calstar/le2-pcb-hardware/flight-module/Flight_board.DXF

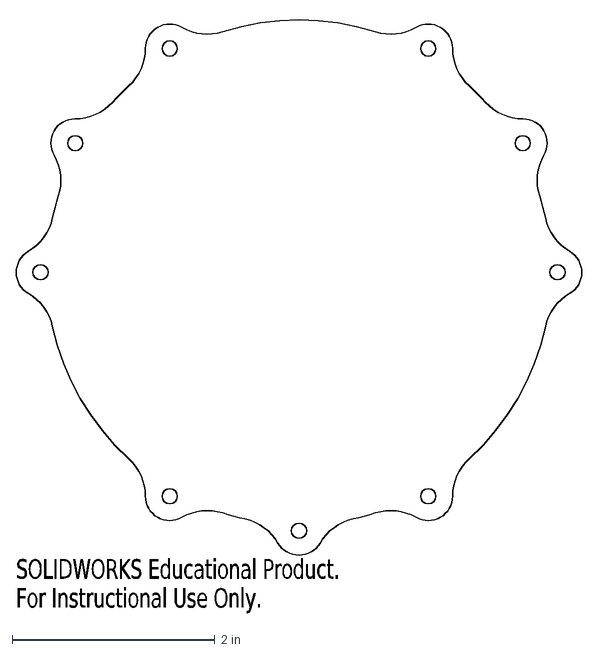
[picture p1: CAD file, 2024-01-30]
flight-module/Flight_board.DXF
SOLIDWORKS Educational Product.
For Instructional Use Only.
