calstar/le2-pcb-hardware/flight-module/Power-board/Power-board.pdf

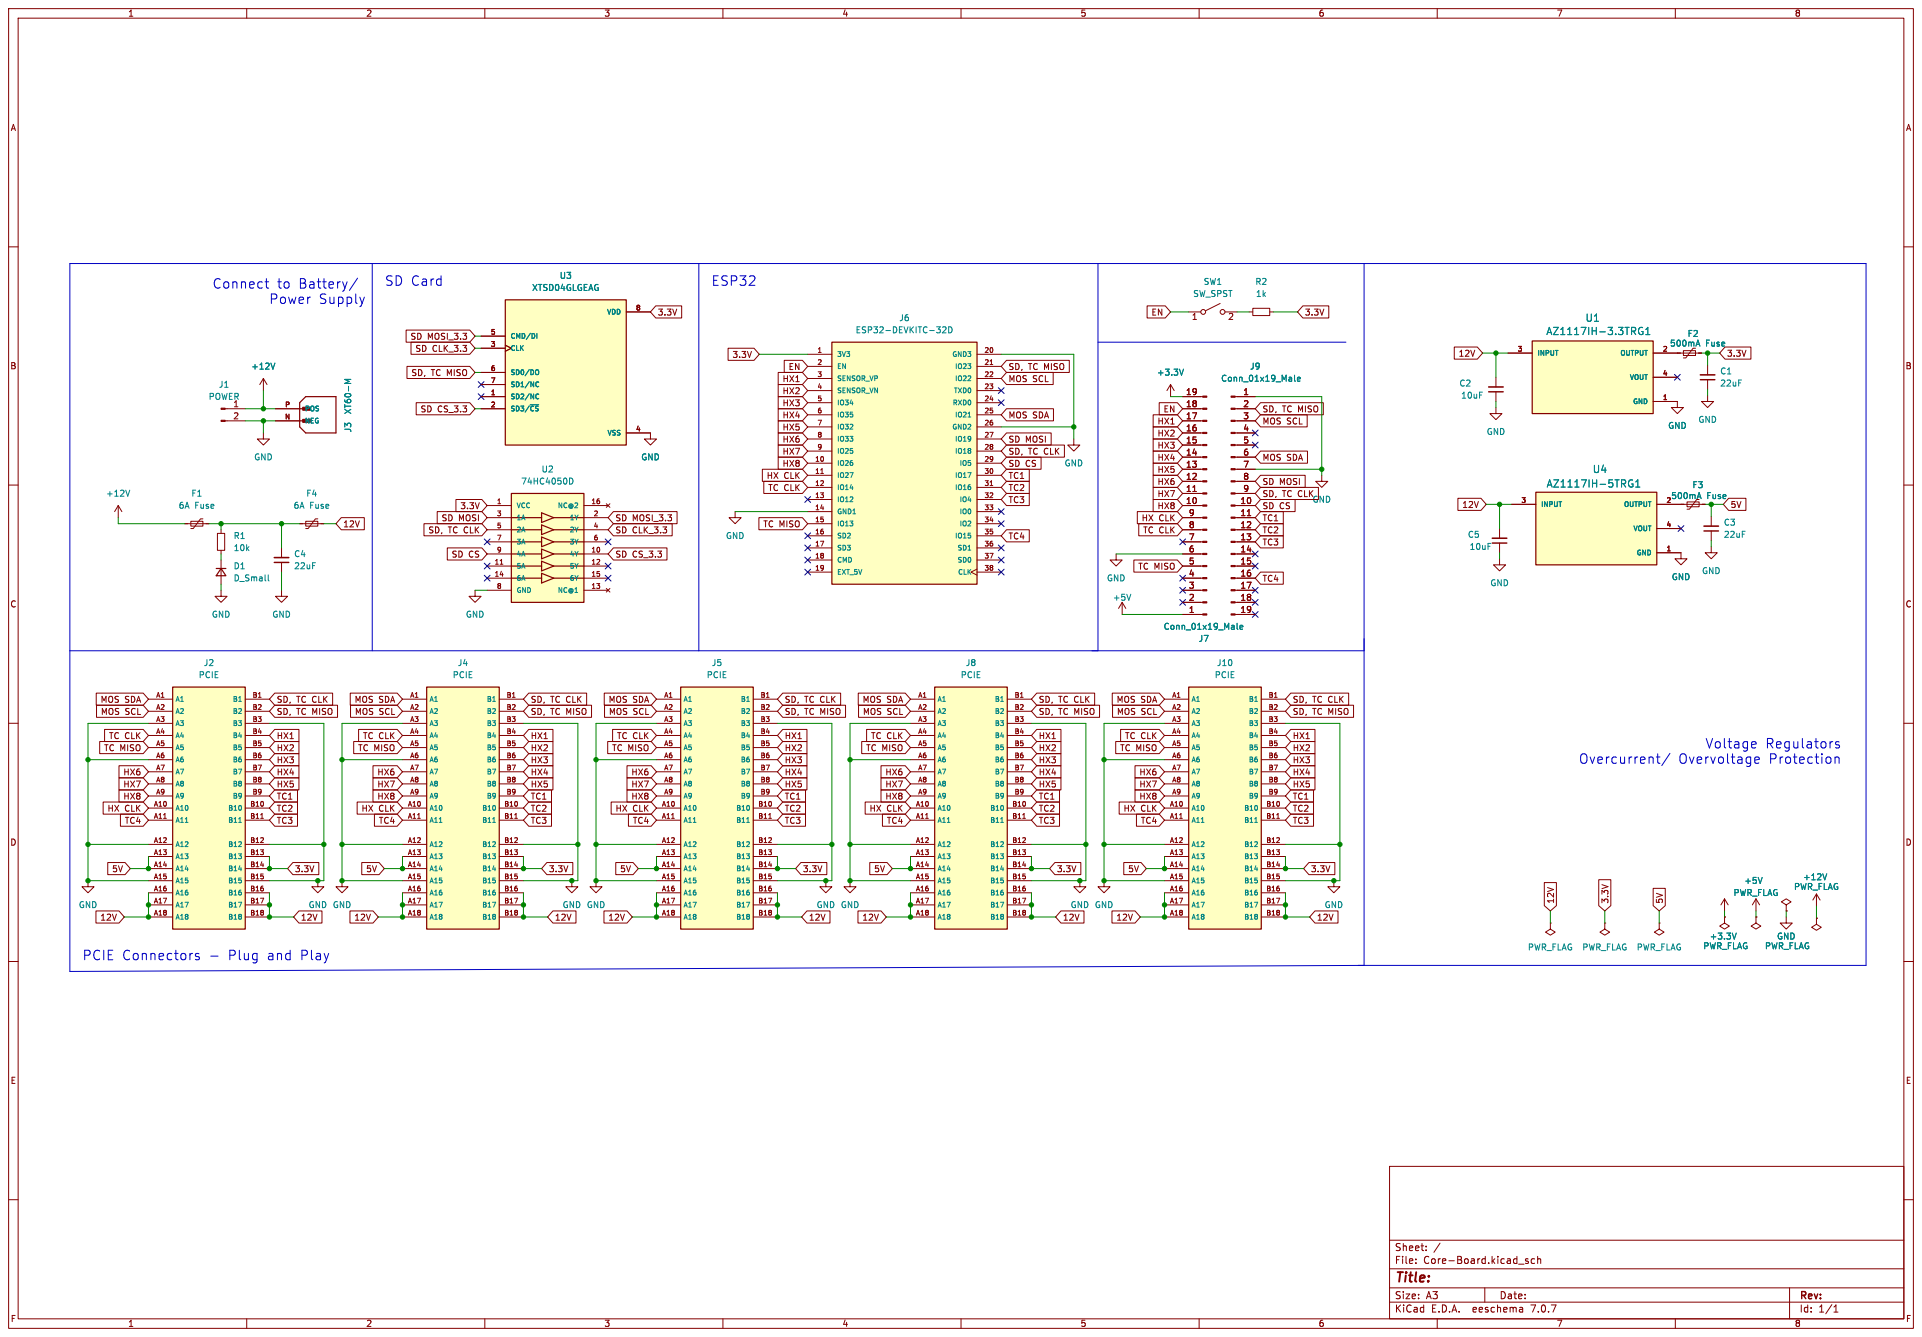
[picture p3: page 1]

EN MOS SCL MOS SDA

TC CLK MOS SCL MOS SDA

Id: 1/1 Title: File: Core-Board.kicad_sch Sheet: /
