calstar/le2-pcb-hardware/ground-module/MOSFET-board/MOSFET-board.pdf

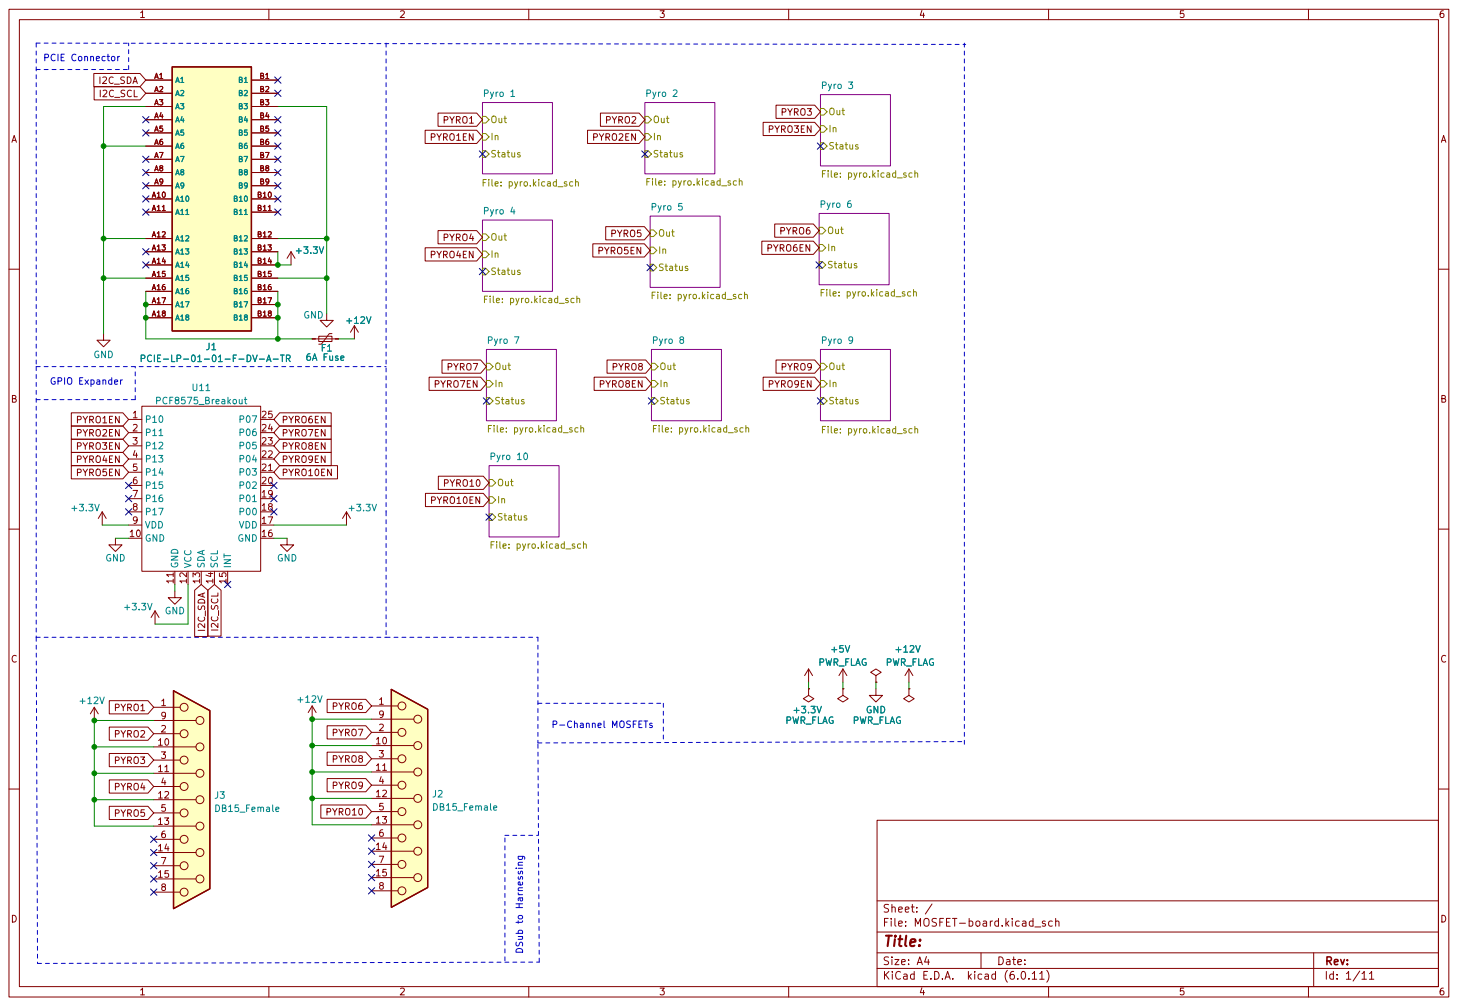
[picture p4: page 1]

In Pyro 7 File: pyro.kicad_sch Status Out
In Pyro 4 File: pyro.kicad_sch Status Out
In Pyro 10 File: pyro.kicad_sch Status Out
PYRO10 PYRO7EN

In Pyro 3 File: pyro.kicad_sch
In Pyro 2 File: pyro.kicad_sch Status Out
In Pyro 9 File: pyro.kicad_sch Status Out

In Pyro 6 File: pyro.kicad_sch Status Out

Id: 1/11 Title: File: MOSFET-board.kicad_sch Sheet: /

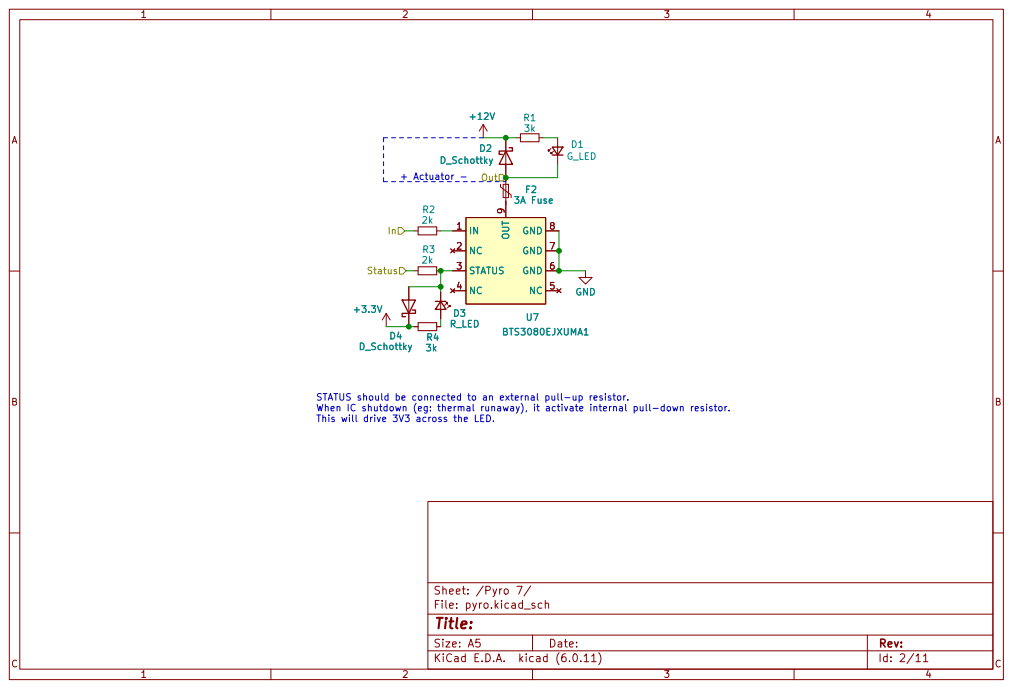
[picture p5: page 2]

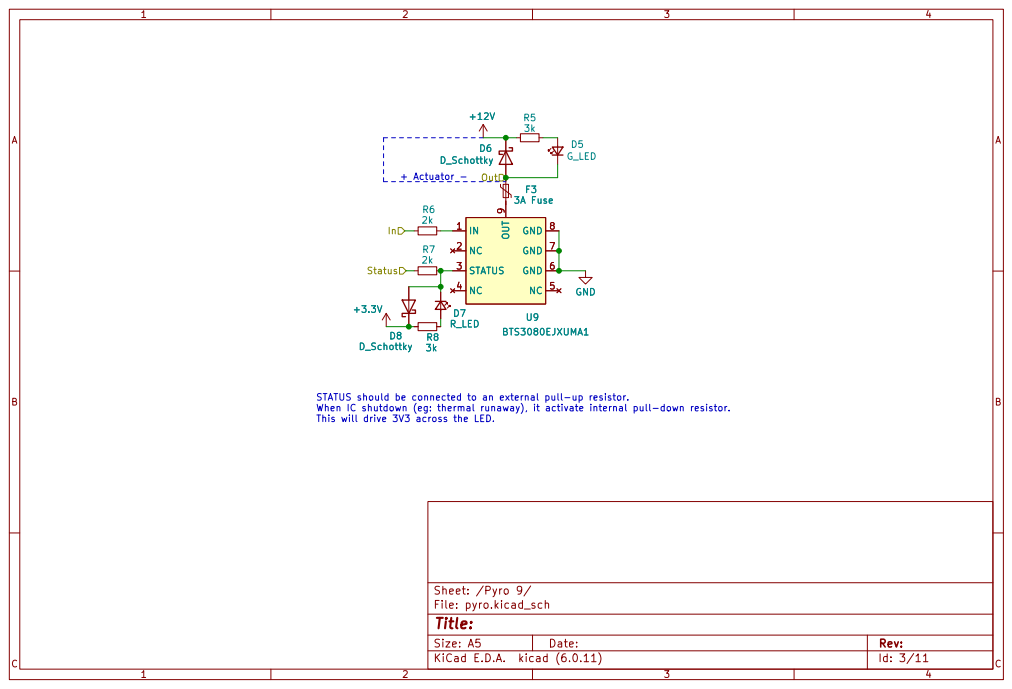
[picture p6: page 3]

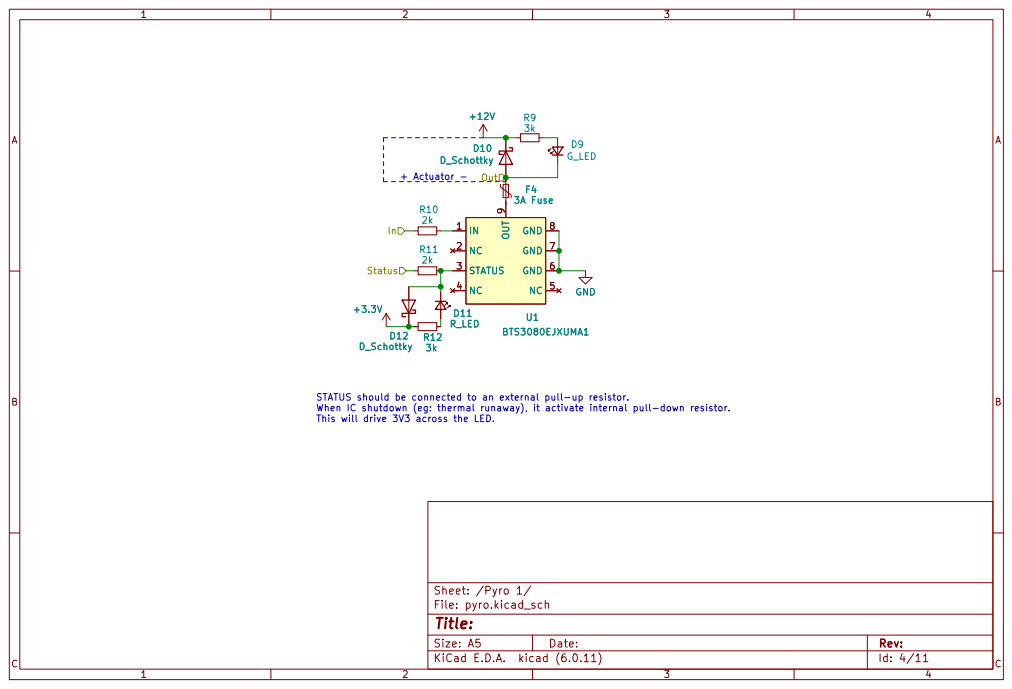
[picture p7: page 4]

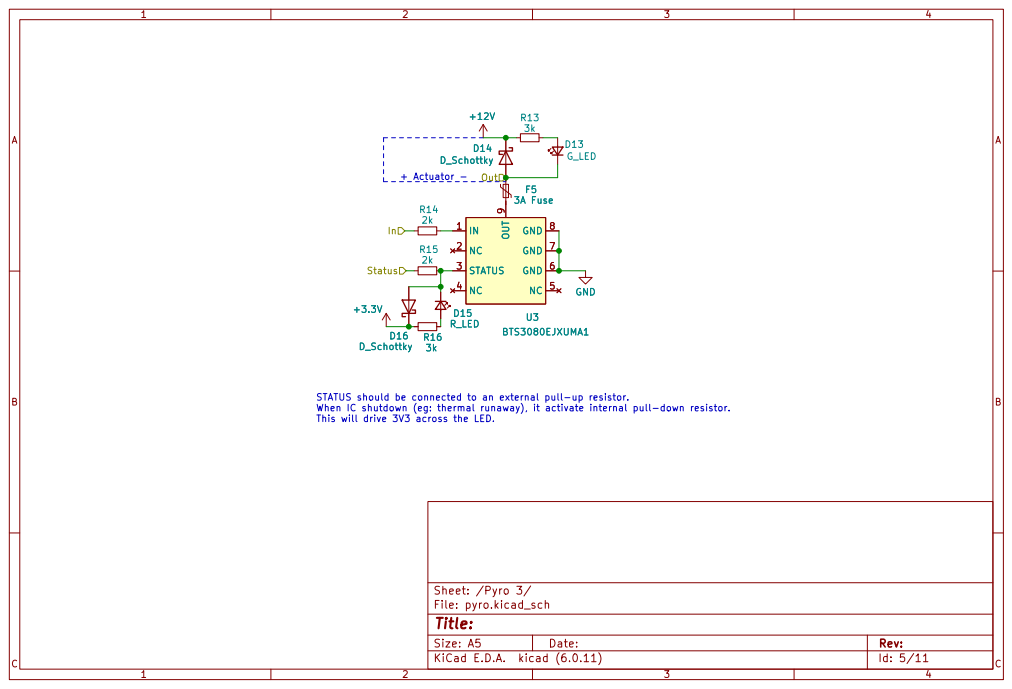
[picture p8: page 5]

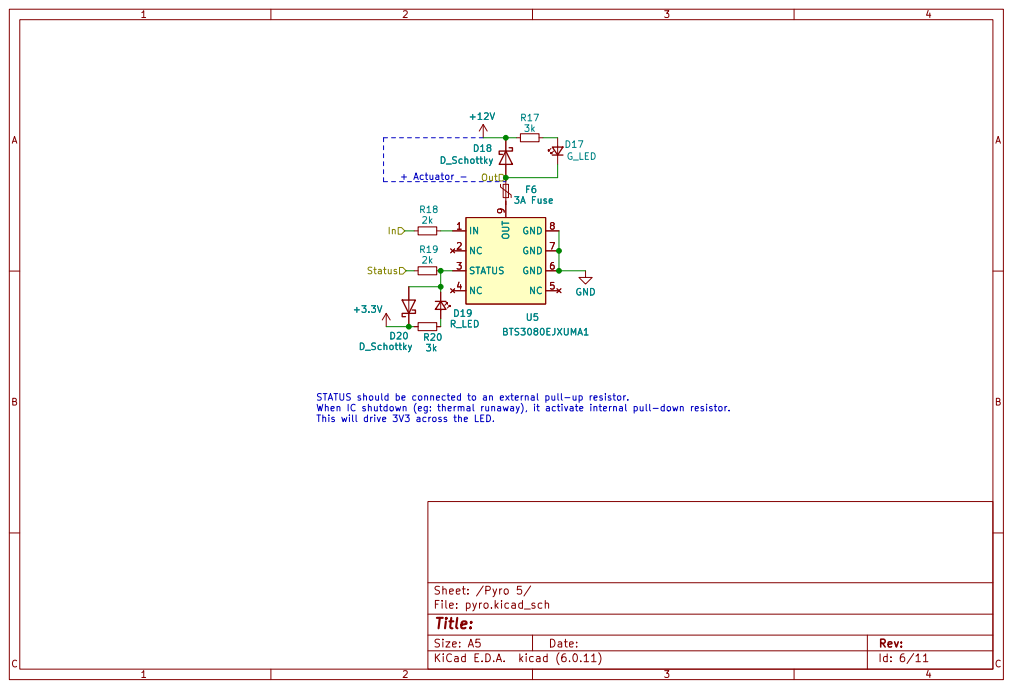
[picture p9: page 6]

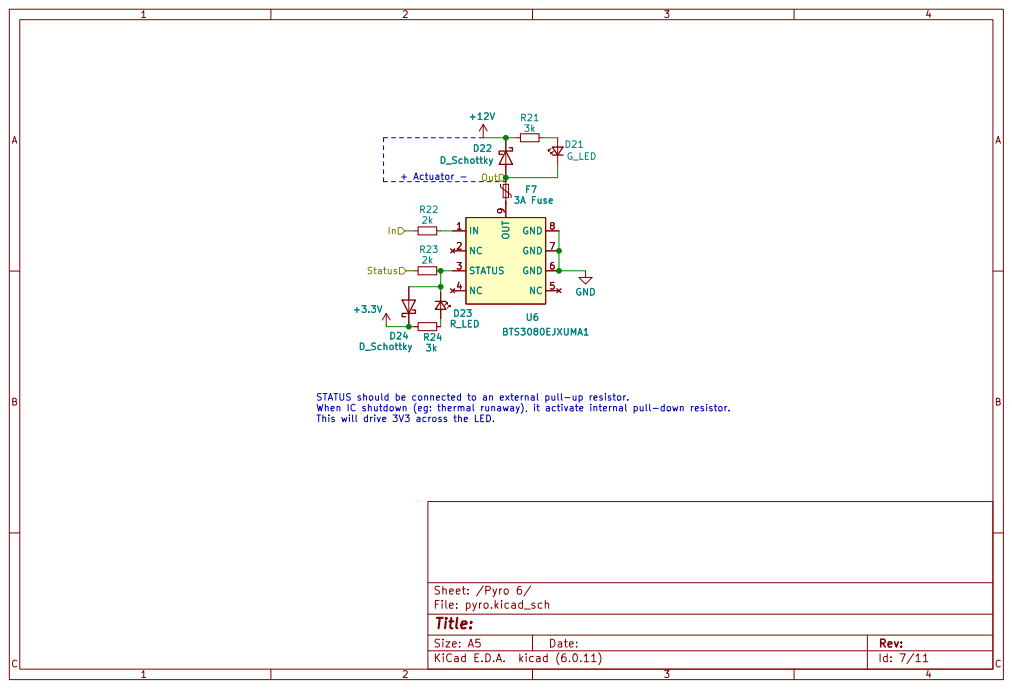
[picture p10: page 7]

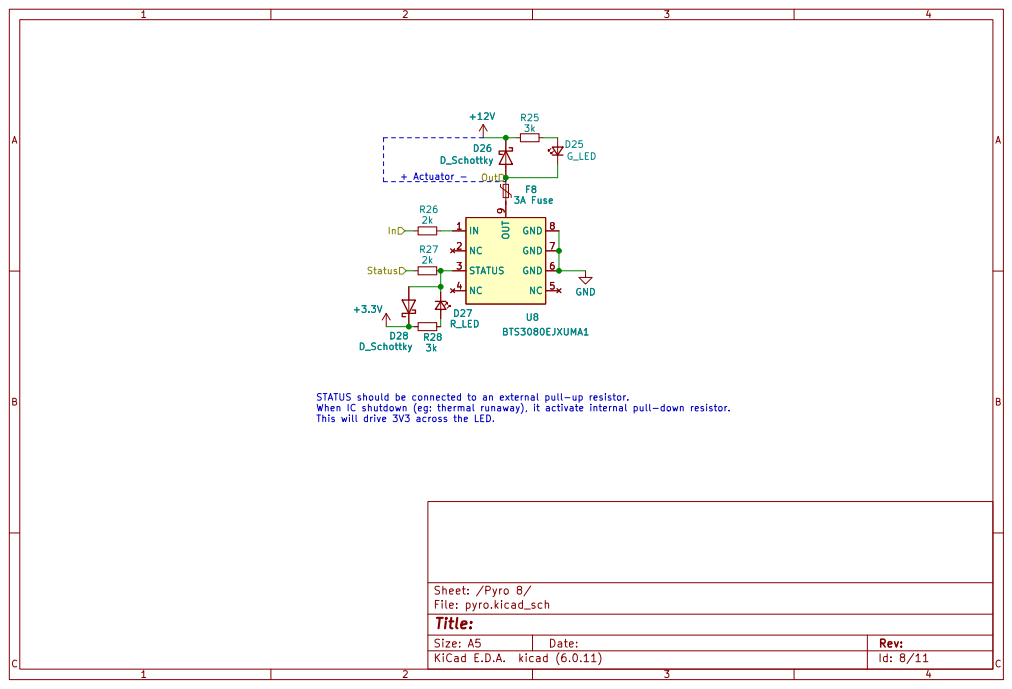
[picture p11: page 8]

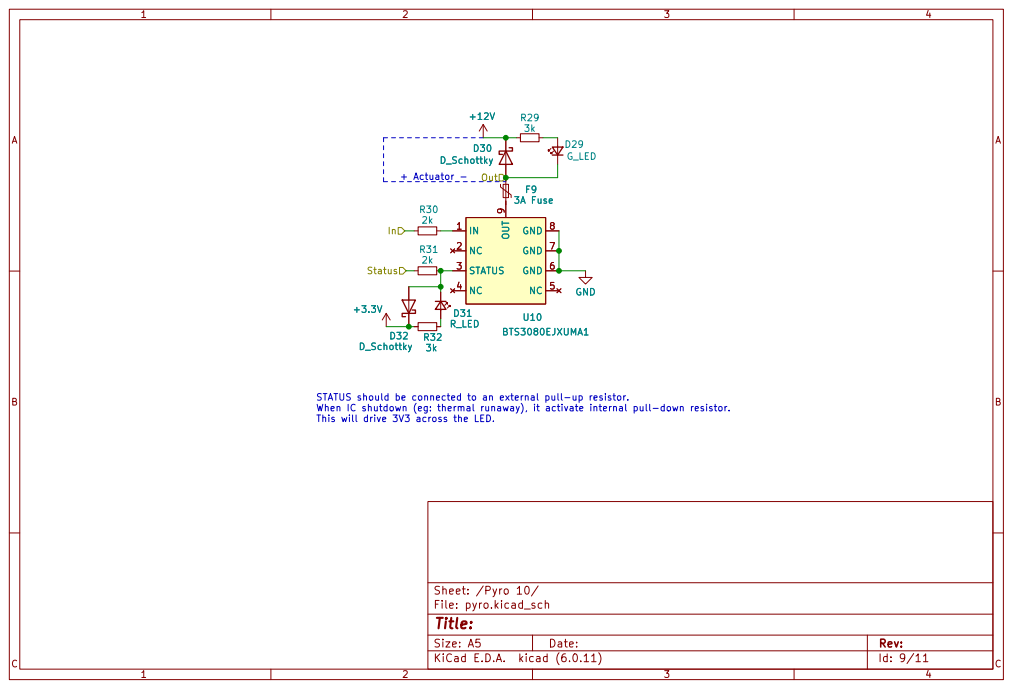
[picture p12: page 9]

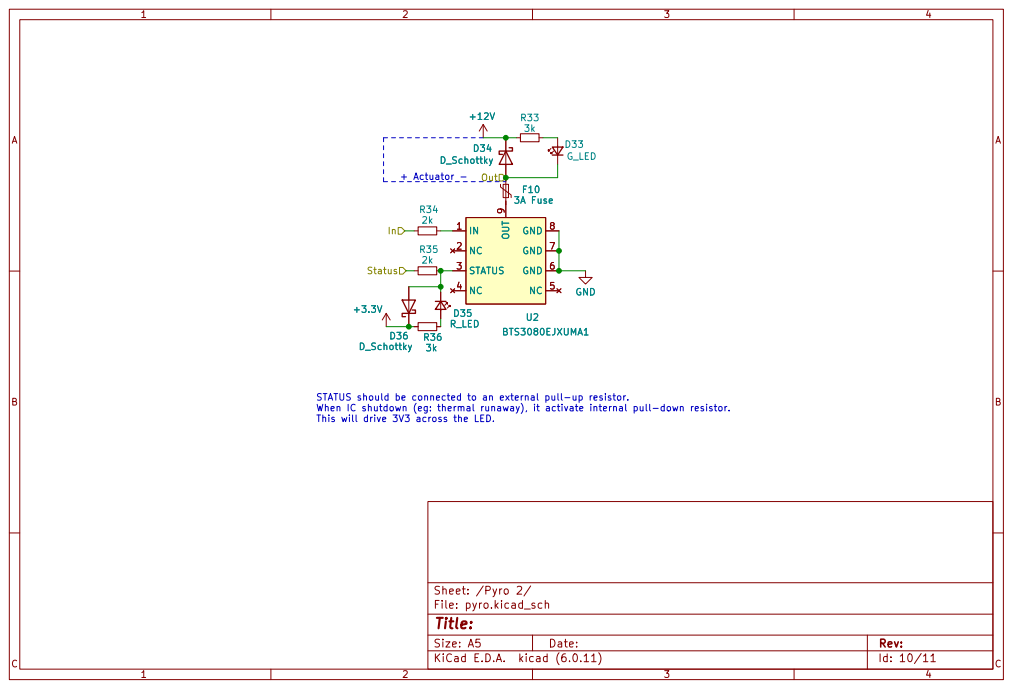
[picture p13: page 10]

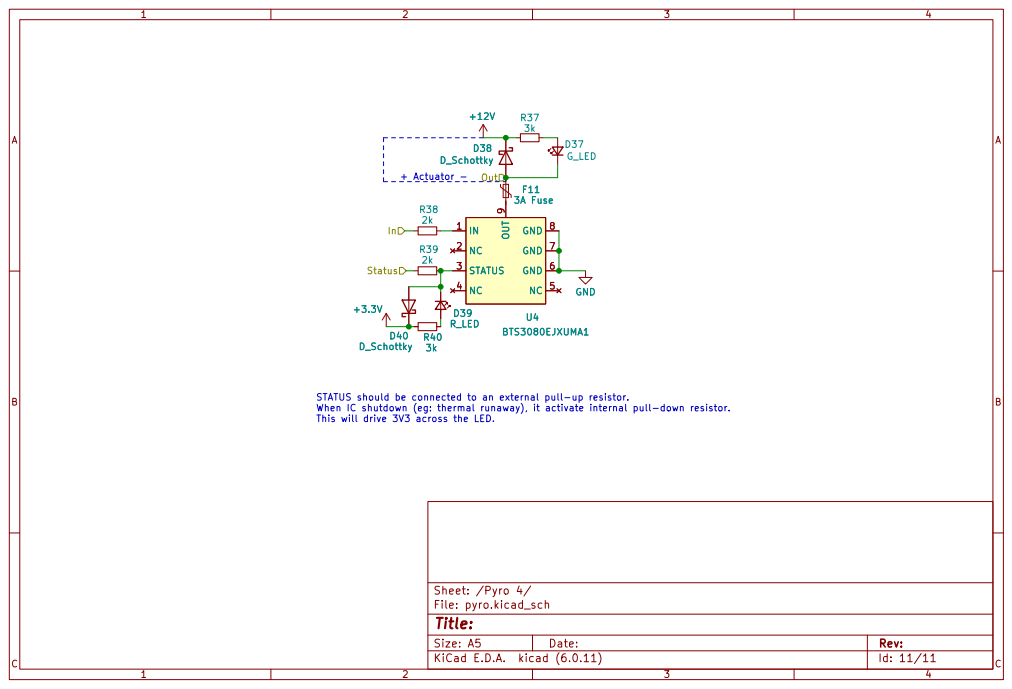
[picture p14: page 11]
