calstar/le2-pcb-hardware/ground-module/TC-board/Gerber for TC/TC-board.pdf

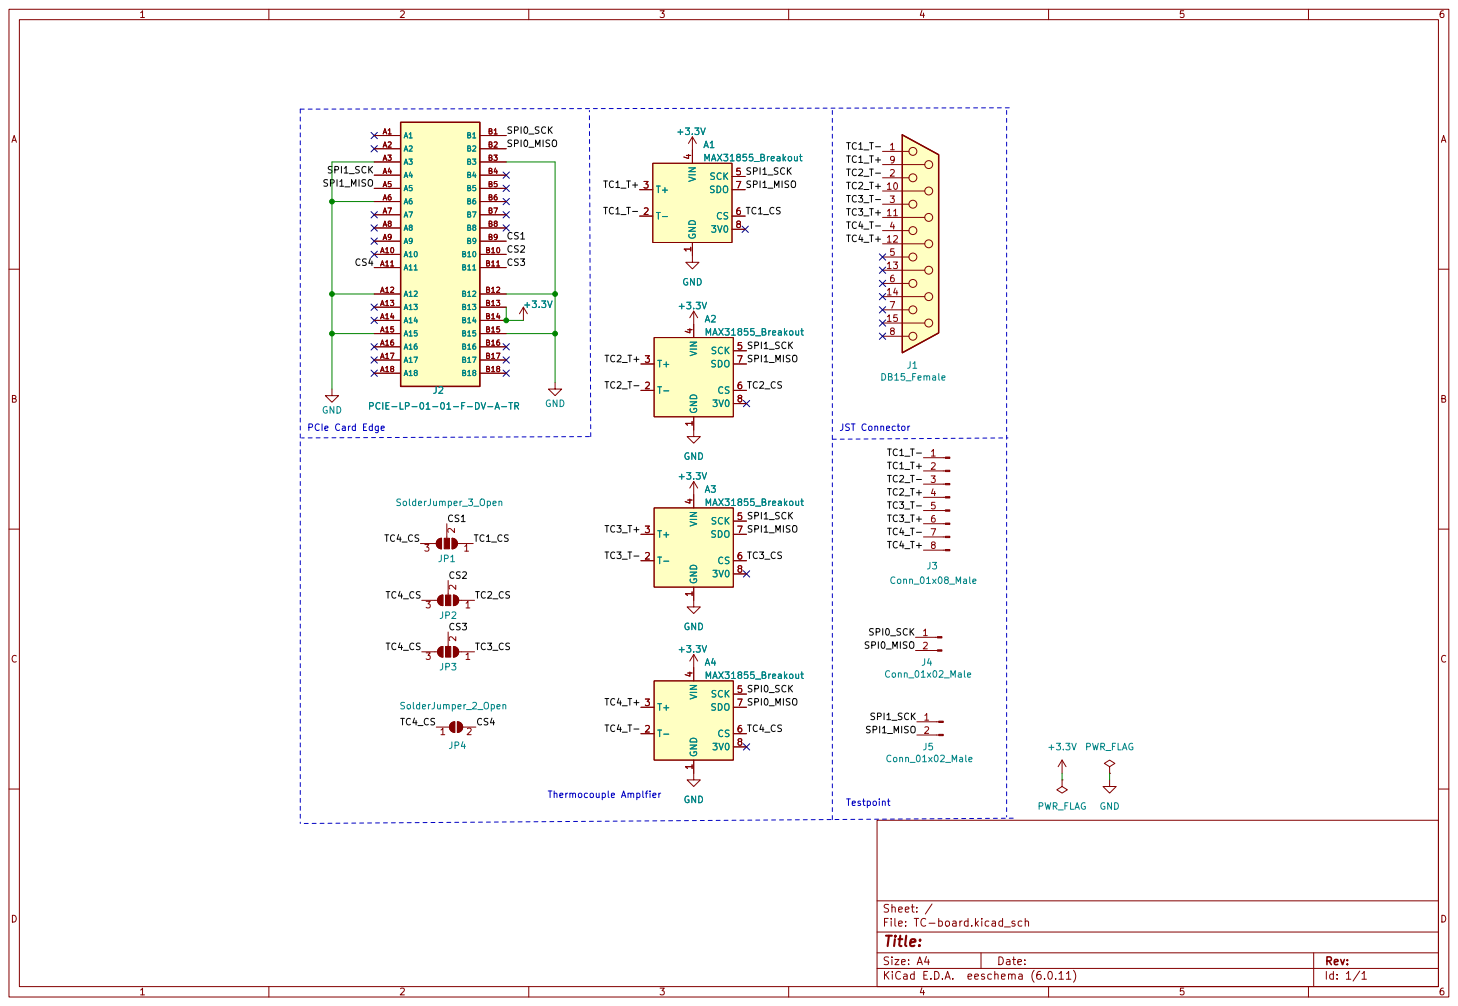
[picture p15: page 1]

J2 PCIE-LP-01-01-F-DV-A-TR
