calstar/le2-pcb-hardware/flight-module/Core-board/Core-board.kicad_pcb

## KiCad design flight-module/Core-board/Core-board.kicad_pcb (2024-05-02)

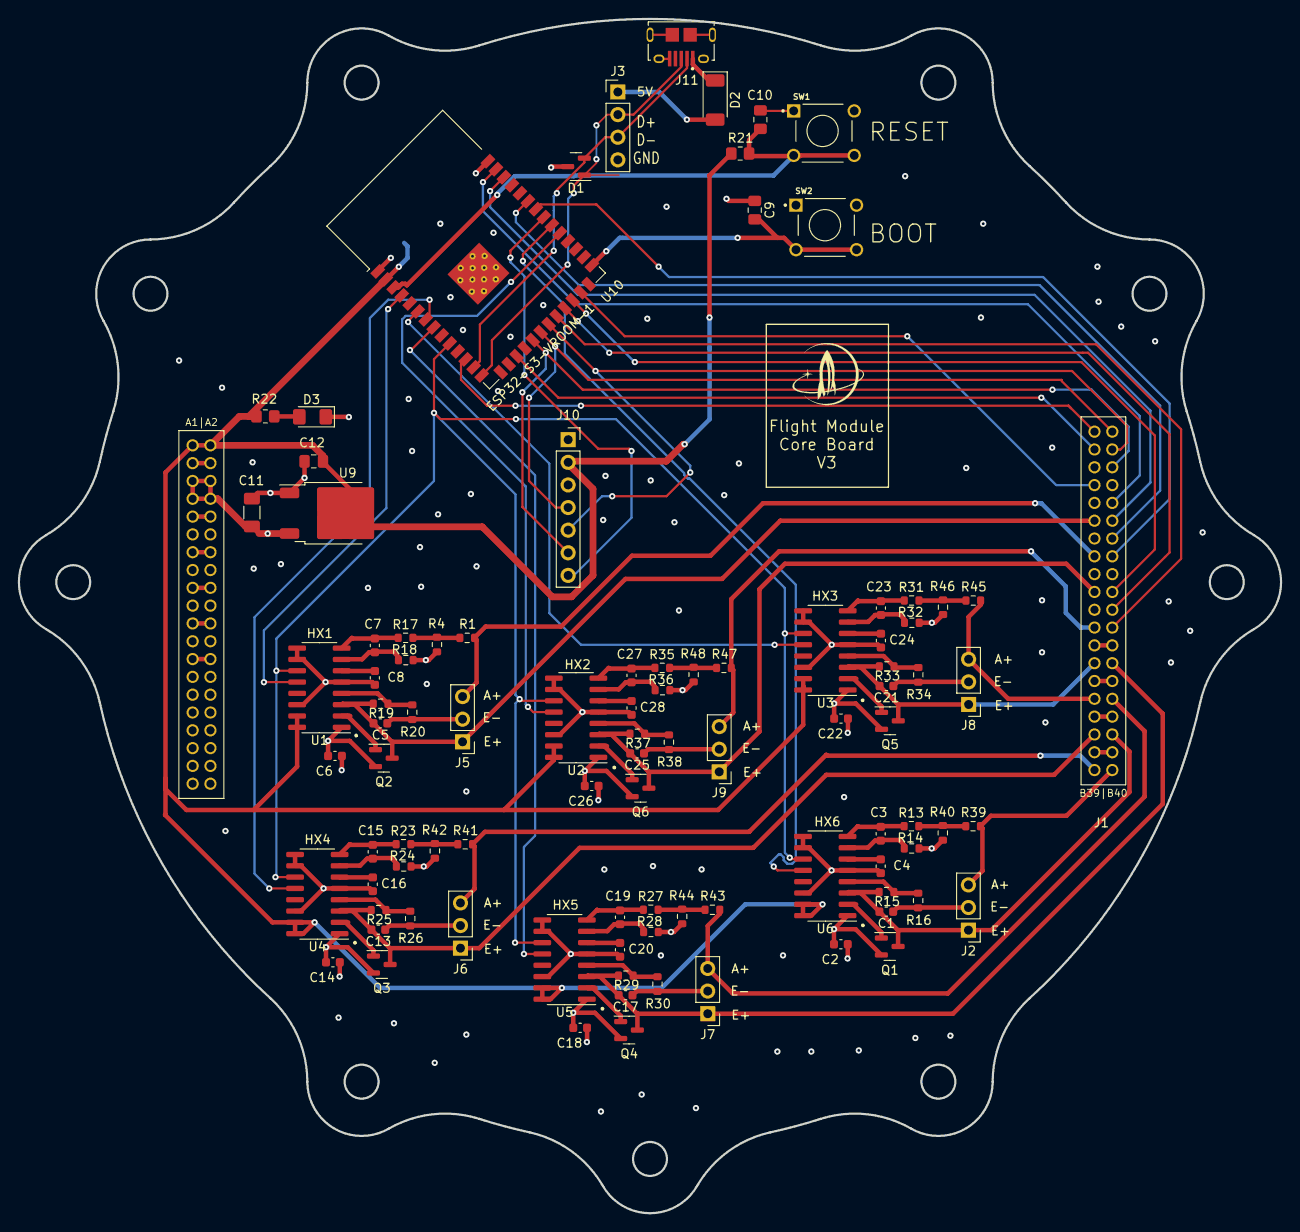
[picture p16: board flight-module/Core-board/Core-board.kicad_pcb from above]

Board: 4 copper layers, 141.7 x 134.1 mm, 95 parts (0 on the bottom side), 78 nets.

Parts:
C1, C2, C5, C6, C13, C14, C17, C18, C21, C22, C25, C26: 10uF; C_0603_1608Metric
C3, C4, C7, C8, C15, C16, C19, C20, C23, C24, C27, C28: 0.1uF; C_0603_1608Metric
C9, C10: 1uF; C_0805_2012Metric_Pad1.18x1.45mm_HandSolder
C11: 10uF; C_1206_3216Metric_Pad1.33x1.80mm_HandSolder
C12: 22uF; C_0805_2012Metric_Pad1.18x1.45mm_HandSolder
D1: PESD12VL2BT; SOT-23
D2: D_Schottky; D_SOD-128
D3: GREEN; LED_1206_3216Metric_Pad1.42x1.75mm_HandSolder
J1: Stack_Shape
J2, J5, J6, J7, J8, J9: Conn_01x03_Pin; PinHeader_1x03_P2.54mm_Vertical
J3: Probe_points; PinHeader_1x04_P2.54mm_Vertical
J10: Conn_01x07_Pin; PinSocket_1x07_P2.54mm_Vertical
J11: 10118194-0011LF; AMPHENOL_10118194-0011LF
Q1, Q2, Q3, Q4, Q5, Q6: MMBT4403LT3G; SOT-23
R1, R39, R41, R43, R45, R47: 100kΩ; R_0603_1608Metric
R4, R40, R42, R44, R46, R48: 2kΩ; R_0603_1608Metric
R13, R14, R17, R18, R23, R24, R27, R28, R31, R32, R35, R36: 100Ω; R_0603_1608Metric
R15, R19, R25, R29, R33, R37: 20kΩ; R_0603_1608Metric
R16, R20, R26, R30, R34, R38: 8.2kΩ; R_0603_1608Metric
R21: 10k; R_0805_2012Metric_Pad1.20x1.40mm_HandSolder
R22: 300; R_0805_2012Metric_Pad1.20x1.40mm_HandSolder
SW1, SW2: 1825910-6; SW_1825910-6-4
U1, U2, U3, U4, U5, U6: HX711; SOP-16_3.9x9.9mm_P1.27mm
U9: AZ1084-3.3; TO-252-2
U10: ESP32-S3-WROOM-1-N16R2; ESP32-S3-WROOM-1

Connections:
+3.3V: C12.1, J1.A1 (Pin_1), J1.A2 (Pin_2), J10.2, R21.1, R22.2, U1.15 (RATE), U1.16 (DVDD), U2.15 (RATE), U2.16 (DVDD), U3.15 (RATE), U3.16 (DVDD), U4.15 (RATE), U4.16 (DVDD), U5.15 (RATE), U5.16 (DVDD), U6.15 (RATE), U6.16 (DVDD), U9.2 (VO), U10.2 (3V3)
+5V: C2.2, C6.2, C11.1, C14.2, C18.2, C22.2, C26.2, D2.2 (A), J1.A5 (Pin_5), J1.A6 (Pin_6), J1.A7 (Pin_7), J1.A8 (Pin_8), J3.1, Q1.2 (E), Q2.2 (E), Q3.2 (E), Q4.2 (E), Q5.2 (E), Q6.2 (E), U1.1 (VSUP), U2.1 (VSUP), U3.1 (VSUP), U4.1 (VSUP), U5.1 (VSUP), U6.1 (VSUP), U9.3 (VI)
/ESP32-S3-WROOM-1-Breakout/BOOT: C9.2, SW2.3, SW2.4, U10.27 (IO0)
/ESP32-S3-WROOM-1-Breakout/EN: C10.2, R21.2, SW1.3, SW1.4, U10.3 (EN)
/ESP32-S3-WROOM-1-Breakout/USB_D+: D1.1 (K), J3.2, J11.3 (D+), U10.14 (IO20)
/ESP32-S3-WROOM-1-Breakout/USB_D-: D1.2 (K), J3.3, J11.2 (D-), U10.13 (IO19)
/HX1_A+: J1.B15 (Pin_15), J5.3, R1.1
/HX1_DT: U1.12 (DOUT), U10.4 (IO4)
/HX1_E+: C5.2, J1.B11 (Pin_11), J5.1, Q2.3 (C), R19.2, U1.3 (AVDD)
/HX2_A+: J1.B23 (Pin_23), J9.3, R47.1
/HX2_DT: U2.12 (DOUT), U10.31 (IO38)
/HX2_E+: C25.2, J1.B19 (Pin_19), J9.1, Q6.3 (C), R37.2, U2.3 (AVDD)
/HX3_A+: J1.B31 (Pin_31), J8.3, R45.1
/HX3_DT: U3.12 (DOUT), U10.6 (IO6)
/HX3_E+: C21.2, J1.B27 (Pin_27), J8.1, Q5.3 (C), R33.2, U3.3 (AVDD)
/HX4_A+: J1.B39 (Pin_39), J6.3, R41.1
/HX4_DT: U4.12 (DOUT), U10.7 (IO7)
/HX4_E+: C13.2, J1.B35 (Pin_35), J6.1, Q3.3 (C), R25.2, U4.3 (AVDD)
/HX5_A+: J1.B32 (Pin_32), J7.3, R43.1
/HX5_DT: U5.12 (DOUT), U10.8 (IO15)
/HX5_E+: C17.2, J1.B28 (Pin_28), J7.1, Q4.3 (C), R29.2, U5.3 (AVDD)
/HX6_A+: J1.B40 (Pin_40), J2.3, R39.1
/HX6_DT: U6.12 (DOUT), U10.32 (IO39)
/HX6_E+: C1.2, J1.B36 (Pin_36), J2.1, Q1.3 (C), R15.2, U6.3 (AVDD)
/HX_CLK: U1.11 (PD_SCK), U2.11 (PD_SCK), U3.11 (PD_SCK), U4.11 (PD_SCK), U5.11 (PD_SCK), U6.11 (PD_SCK), U10.10 (IO17)
/I2C_SCL: J1.B3 (Pin_3), U10.17 (IO9)
/I2C_SDA: J1.B1 (Pin_1), U10.12 (IO8)
/PYRO1EN: J1.B7 (Pin_7), U10.25 (IO48)
/PYRO2EN: J1.B20 (Pin_20), U10.24 (IO47)
/PYRO3EN: J1.B22 (Pin_22), U10.23 (IO21)
/PYRO4EN: J1.B24 (Pin_24), U10.22 (IO14)
/SD_CS: J10.7, U10.33 (IO40)
/SPI_CLK: J1.B2 (Pin_2), J10.4, U10.20 (IO12)
/SPI_MISO: J1.B4 (Pin_4), J10.5, U10.21 (IO13)
/SPI_MOSI: J1.B6 (Pin_6), J10.6, U10.19 (IO11)
/TC1_CS: J1.B10 (Pin_10), U10.39 (IO1)
/TC2_CS: J1.B12 (Pin_12), U10.38 (IO2)
/TC3_CS: J1.B14 (Pin_14), U10.35 (IO42)
/TC4_CS: J1.B16 (Pin_16), U10.34 (IO41)
GND: C1.1, C2.1, C4.1, C5.1, C6.1, C8.1, C9.1, C10.1, C11.2, C12.2, C13.1, C14.1, C16.1, C17.1, C18.1, C20.1, C21.1, C22.1, C24.1, C25.1, C26.1, C28.1, D1.3 (A), D3.1 (K), J1.A3 (Pin_3), J1.A4 (Pin_4), J1.A9 (Pin_9), J1.A10 (Pin_10), J1.A13 (Pin_13), J1.A14 (Pin_14), J1.A17 (Pin_17), J1.A18 (Pin_18), J1.A21 (Pin_21), J1.A22 (Pin_22), J1.A25 (Pin_25), J1.A26 (Pin_26), J1.B5 (Pin_5), J1.B8 (Pin_8), J1.B9 (Pin_9), J1.B13 (Pin_13), J1.B17 (Pin_17), J1.B18 (Pin_18), J1.B21 (Pin_21), J1.B25 (Pin_25), J1.B26 (Pin_26), J1.B29 (Pin_29), J1.B30 (Pin_30), J1.B33 (Pin_33), J1.B34 (Pin_34), J1.B37 (Pin_37), J1.B38 (Pin_38), J2.2, J3.4, J5.2, J6.2, J7.2, J8.2, J9.2, J10.3, J11.5 (GND), J11.S1 (SHIELD), J11.S2 (SHIELD__1), J11.S3 (SHIELD__2), J11.S4 (SHIELD__3), J11.S5 (SHIELD__4), J11.S6 (SHIELD__5), R4.1, R14.2, R16.1, R18.2, R20.1, R24.2, R26.1, R28.2, R30.1, R32.2, R34.1, R36.2, R38.1, R40.1, R42.1, R44.1, R46.1, R48.1, SW1.1, SW1.2, SW2.1, SW2.2, U1.5 (AGND), U1.9 (INB-), U1.10 (INB+), U1.14 (XI), U2.5 (AGND), U2.9 (INB-), U2.10 (INB+), U2.14 (XI), U3.5 (AGND), U3.9 (INB-), U3.10 (INB+), U3.14 (XI), U4.5 (AGND), U4.9 (INB-), U4.10 (INB+), U4.14 (XI), U5.5 (AGND), U5.9 (INB-), U5.10 (INB+), U5.14 (XI), U6.5 (AGND), U6.9 (INB-), U6.10 (INB+), U6.14 (XI), U9.1 (GND), U10.1 (GND), U10.40 (GND__1), U10.41 (GND__2)
unnamed: D2.1 (K), J11.1 (VBUS)
unnamed: D3.2 (A), R22.1
unnamed: Q1.1 (B), U6.2 (BASE)
unnamed: Q2.1 (B), U1.2 (BASE)
unnamed: Q3.1 (B), U4.2 (BASE)
unnamed: Q4.1 (B), U5.2 (BASE)
unnamed: Q5.1 (B), U3.2 (BASE)
unnamed: Q6.1 (B), U2.2 (BASE)
unnamed: R1.2, R4.2, R17.2
unnamed: R13.2, R39.2, R40.2
unnamed: R23.2, R41.2, R42.2
unnamed: R27.2, R43.2, R44.2
unnamed: R31.2, R45.2, R46.2
unnamed: R35.2, R47.2, R48.2
unnamed: C7.2, R17.1, U1.8 (INA+)
unnamed: C7.1, R18.1, U1.7 (INA-)
unnamed: C8.2, U1.6 (VBG)
unnamed: R19.1, R20.2, U1.4 (VFB)
unnamed: C27.2, R35.1, U2.8 (INA+)
unnamed: C27.1, R36.1, U2.7 (INA-)
unnamed: C28.2, U2.6 (VBG)
unnamed: R37.1, R38.2, U2.4 (VFB)
unnamed: C23.2, R31.1, U3.8 (INA+)
unnamed: C23.1, R32.1, U3.7 (INA-)
unnamed: C24.2, U3.6 (VBG)
unnamed: R33.1, R34.2, U3.4 (VFB)
unnamed: C15.2, R23.1, U4.8 (INA+)
unnamed: C15.1, R24.1, U4.7 (INA-)
unnamed: C16.2, U4.6 (VBG)
unnamed: R25.1, R26.2, U4.4 (VFB)
unnamed: C19.2, R27.1, U5.8 (INA+)
unnamed: C19.1, R28.1, U5.7 (INA-)
unnamed: C20.2, U5.6 (VBG)
unnamed: R29.1, R30.2, U5.4 (VFB)
unnamed: C3.2, R13.1, U6.8 (INA+)
unnamed: C3.1, R14.1, U6.7 (INA-)
unnamed: C4.2, U6.6 (VBG)
unnamed: R15.1, R16.2, U6.4 (VFB)
