calstar/le2-pcb-hardware/flight-module/Connector-board/Connector-board.kicad_pcb

## KiCad design flight-module/Connector-board/Connector-board.kicad_pcb (2024-03-26)

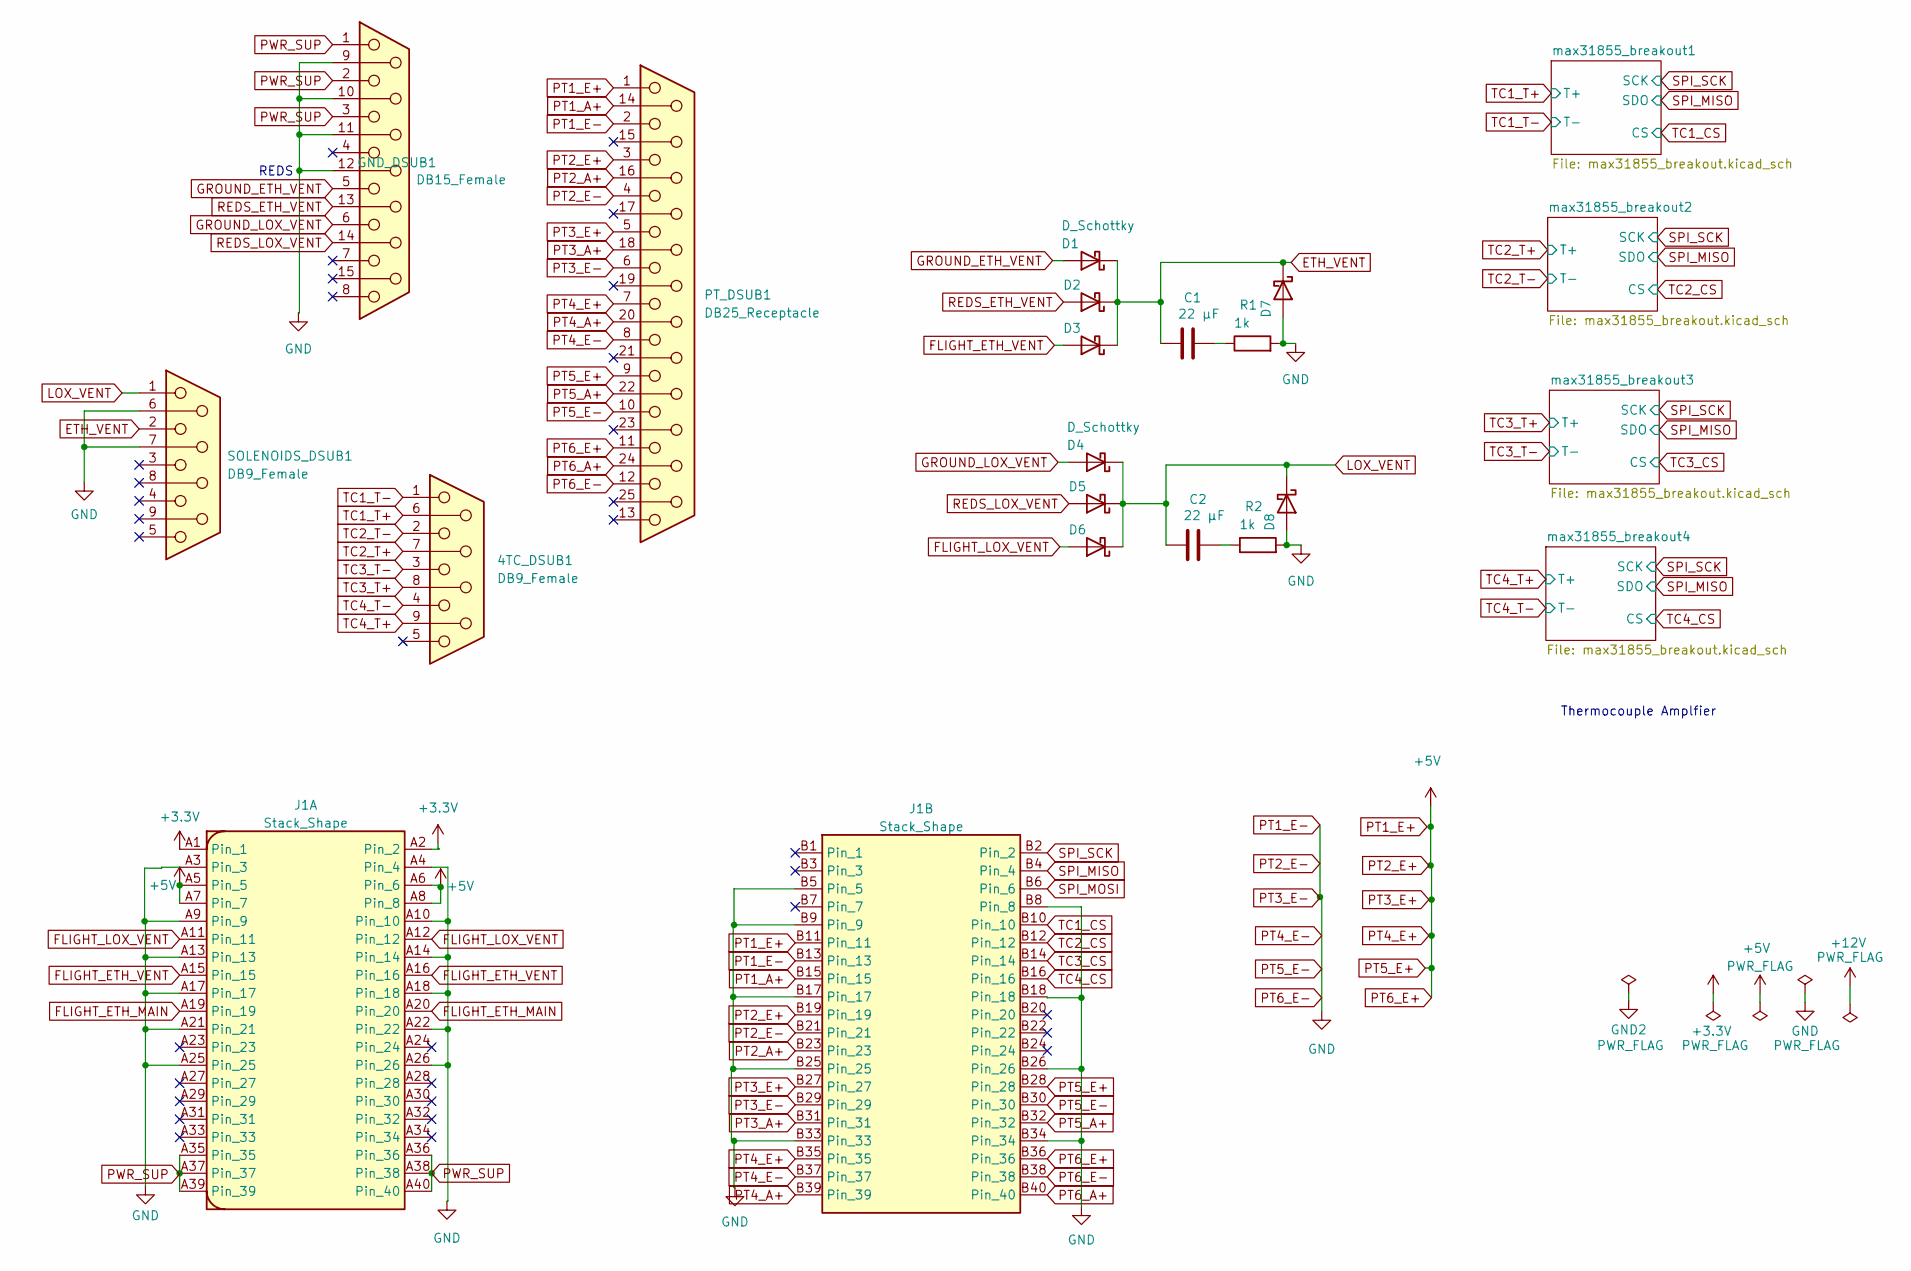
[picture p17: schematic Connector-board.kicad_sch]

Parts:
4TC_DSUB1: DB9_Female; DSUB-9_Female_Vertical_P2.77x2.84mm_MountingHoles
C1, C2: 22 µF; D_0603_1608Metric
D1, D2, D3, D4, D5, D6, D7, D8: D_Schottky; D_SOD-128
GND_DSUB1: DB15_Female; DSUB-15_Female_Vertical_P2.77x2.84mm_MountingHoles
J1: Stack_Shape
PT_DSUB1: DB25_Receptacle; DSUB-25_Female_Vertical_P2.77x2.84mm_MountingHoles
R1, R2: 1k; D_0603_1608Metric
SOLENOIDS_DSUB1: DB9_Female; DSUB-9_Female_Vertical_P2.77x2.84mm_MountingHoles

Connections:
+3.3V: J1.A1 (Pin_1), J1.A2 (Pin_2); also elsewhere on the board
ETH_VENT: C1.1, D1.1 (K), D2.1 (K), D3.1 (K), D7.1 (K), SOLENOIDS_DSUB1.2
FLIGHT_ETH_MAIN: J1.A19 (Pin_19), J1.A20 (Pin_20)
FLIGHT_ETH_VENT: D3.2 (A), J1.A15 (Pin_15), J1.A16 (Pin_16)
FLIGHT_LOX_VENT: D6.2 (A), J1.A11 (Pin_11), J1.A12 (Pin_12)
GROUND_ETH_VENT: D1.2 (A), GND_DSUB1.5
GROUND_LOX_VENT: D4.2 (A), GND_DSUB1.6
LOX_VENT: C2.1, D4.1 (K), D5.1 (K), D6.1 (K), D8.1 (K), SOLENOIDS_DSUB1.1
unnamed: C1.2, R1.1
unnamed: C2.2, R2.1
PT1_A+: J1.B15 (Pin_15), PT_DSUB1.14
PT1_E+: J1.A5 (Pin_5), J1.A6 (Pin_6), J1.A7 (Pin_7), J1.A8 (Pin_8), J1.B11 (Pin_11), J1.B19 (Pin_19), J1.B27 (Pin_27), J1.B28 (Pin_28), J1.B35 (Pin_35), J1.B36 (Pin_36), PT_DSUB1.1, PT_DSUB1.3, PT_DSUB1.5, PT_DSUB1.7, PT_DSUB1.9, PT_DSUB1.11
PT1_E-: D7.2 (A), D8.2 (A), GND_DSUB1.9, GND_DSUB1.10, GND_DSUB1.11 (P111), GND_DSUB1.12, J1.A3 (Pin_3), J1.A4 (Pin_4), J1.A9 (Pin_9), J1.A10 (Pin_10), J1.A13 (Pin_13), J1.A14 (Pin_14), J1.A17 (Pin_17), J1.A18 (Pin_18), J1.A21 (Pin_21), J1.A22 (Pin_22), J1.A25 (Pin_25), J1.A26 (Pin_26), J1.B5 (Pin_5), J1.B8 (Pin_8), J1.B9 (Pin_9), J1.B13 (Pin_13), J1.B17 (Pin_17), J1.B18 (Pin_18), J1.B21 (Pin_21), J1.B25 (Pin_25), J1.B26 (Pin_26), J1.B29 (Pin_29), J1.B30 (Pin_30), J1.B33 (Pin_33), J1.B34 (Pin_34), J1.B37 (Pin_37), J1.B38 (Pin_38), PT_DSUB1.2, PT_DSUB1.4, PT_DSUB1.6, PT_DSUB1.8, PT_DSUB1.10, PT_DSUB1.12, R1.2, R2.2, SOLENOIDS_DSUB1.6, SOLENOIDS_DSUB1.7; also elsewhere on the board
PT2_A+: J1.B23 (Pin_23), PT_DSUB1.16
PT3_A+: J1.B31 (Pin_31), PT_DSUB1.18
PT4_A+: J1.B39 (Pin_39), PT_DSUB1.20
PT5_A+: J1.B32 (Pin_32), PT_DSUB1.22
PT6_A+: J1.B40 (Pin_40), PT_DSUB1.24
PWR_SUP: GND_DSUB1.1, GND_DSUB1.2, GND_DSUB1.3, J1.A35 (Pin_35), J1.A36 (Pin_36), J1.A37 (Pin_37), J1.A38 (Pin_38), J1.A39 (Pin_39), J1.A40 (Pin_40)
REDS_ETH_VENT: D2.2 (A), GND_DSUB1.13
REDS_LOX_VENT: D5.2 (A), GND_DSUB1.14
SPI_MISO: J1.B4 (Pin_4); also elsewhere on the board
SPI_MOSI: J1.B6 (Pin_6)
SPI_SCK: J1.B2 (Pin_2); also elsewhere on the board
TC1_CS: J1.B10 (Pin_10); also elsewhere on the board
TC1_T+: 4TC_DSUB1.6; also elsewhere on the board
TC1_T-: 4TC_DSUB1.1; also elsewhere on the board
TC2_CS: J1.B12 (Pin_12); also elsewhere on the board
TC2_T+: 4TC_DSUB1.7; also elsewhere on the board
TC2_T-: 4TC_DSUB1.2; also elsewhere on the board
TC3_CS: J1.B14 (Pin_14); also elsewhere on the board
TC3_T+: 4TC_DSUB1.8; also elsewhere on the board
TC3_T-: 4TC_DSUB1.3; also elsewhere on the board
TC4_CS: J1.B16 (Pin_16); also elsewhere on the board
TC4_T+: 4TC_DSUB1.9; also elsewhere on the board
TC4_T-: 4TC_DSUB1.4; also elsewhere on the board

Notes on the sheet:
Thermocouple Amplfier
REDS

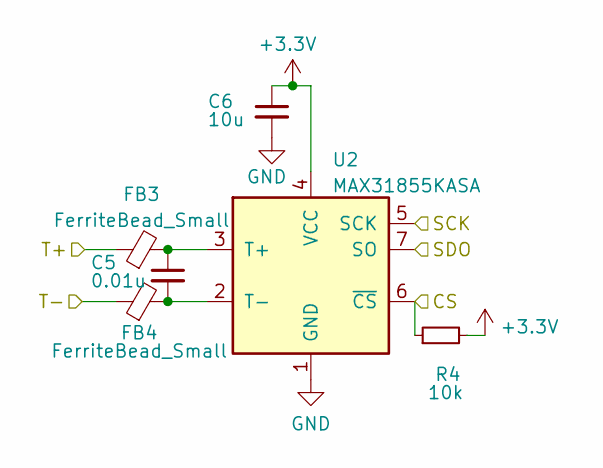
[picture p18: schematic max31855_breakout.kicad_sch]

Parts:
C5: 0.01u; C_0603_1608Metric
C6: 10u; C_0603_1608Metric
FB3, FB4: FerriteBead_Small; C_0603_1608Metric
R4: 10k; R_0603_1608Metric
U2: MAX31855KASA; SOIC-8_3.9x4.9mm_P1.27mm

Connections:
+3.3V: C6.1, R4.2, U2.4 (VCC); also elsewhere on the board
unnamed: C5.1, FB3.2, U2.3 (T+)
unnamed: C5.2, FB4.2, U2.2 (T-)
PT1_E-: C6.2, U2.1 (GND); also elsewhere on the board
SPI_MISO: U2.7 (SO); also elsewhere on the board
SPI_SCK: U2.5 (SCK); also elsewhere on the board
TC4_CS: R4.1, U2.6 (~CS); also elsewhere on the board
TC4_T+: FB3.1; also elsewhere on the board
TC4_T-: FB4.1; also elsewhere on the board

Parts of its further copies:
C3, C7, C9: 0.01u; C_0603_1608Metric
C4, C8, C10: 10u; C_0603_1608Metric
FB1, FB2, FB5, FB6, FB7, FB8: FerriteBead_Small; C_0603_1608Metric
R3, R5, R6: 10k; R_0603_1608Metric
U1, U3, U4: MAX31855KASA; SOIC-8_3.9x4.9mm_P1.27mm

Connections of its further copies:
+3.3V: C4.1, C8.1, C10.1, R3.2, R5.2, R6.2, U1.4 (VCC), U3.4 (VCC), U4.4 (VCC); also elsewhere on the board
unnamed: C3.1, FB1.2, U1.3 (T+)
unnamed: C3.2, FB2.2, U1.2 (T-)
unnamed: C7.1, FB5.2, U3.3 (T+)
unnamed: C7.2, FB6.2, U3.2 (T-)
unnamed: C9.1, FB7.2, U4.3 (T+)
unnamed: C9.2, FB8.2, U4.2 (T-)
PT1_E-: C4.2, C8.2, C10.2, U1.1 (GND), U3.1 (GND), U4.1 (GND); also elsewhere on the board
SPI_MISO: U1.7 (SO), U3.7 (SO), U4.7 (SO); also elsewhere on the board
SPI_SCK: U1.5 (SCK), U3.5 (SCK), U4.5 (SCK); also elsewhere on the board
TC1_CS: R3.1, U1.6 (~CS); also elsewhere on the board
TC1_T+: FB1.1; also elsewhere on the board
TC1_T-: FB2.1; also elsewhere on the board
TC2_CS: R5.1, U3.6 (~CS); also elsewhere on the board
TC2_T+: FB5.1; also elsewhere on the board
TC2_T-: FB6.1; also elsewhere on the board
TC3_CS: R6.1, U4.6 (~CS); also elsewhere on the board
TC3_T+: FB7.1; also elsewhere on the board
TC3_T-: FB8.1; also elsewhere on the board

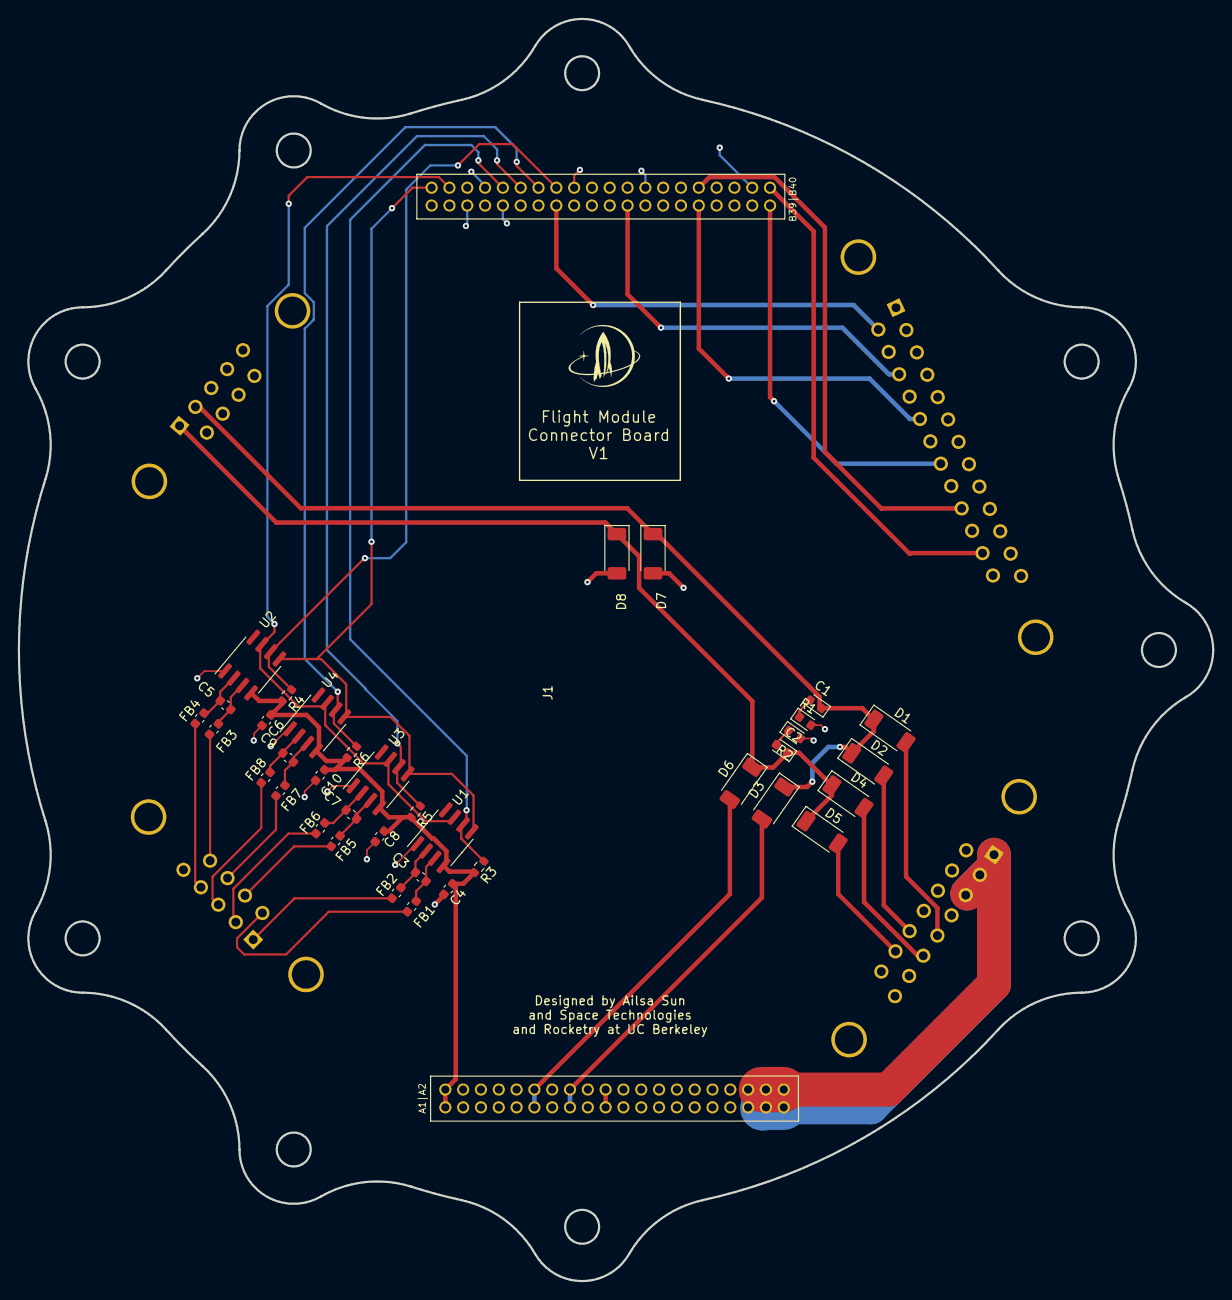
[picture p19: board Connector-board.kicad_pcb from above]

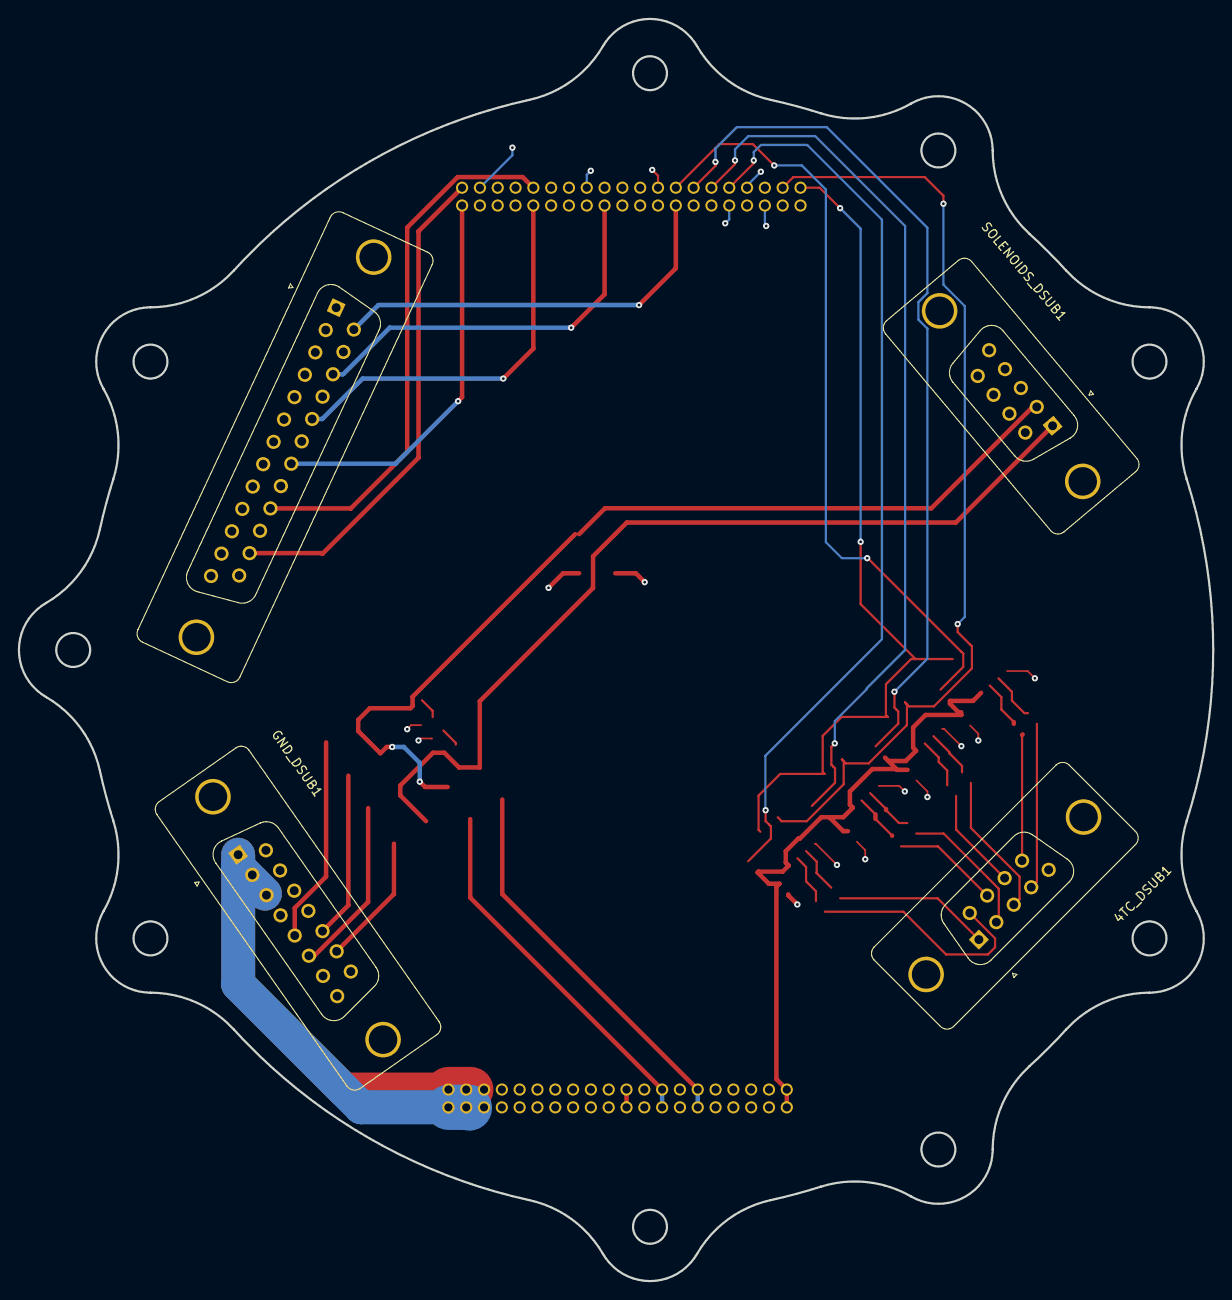
[picture p20: board Connector-board.kicad_pcb from below]

Board: 4 copper layers, 134.1 x 141.7 mm, 41 parts (4 on the bottom side), 43 nets.
