calstar/le2-pcb-hardware/flight-module/Power-board/Power-board.kicad_pcb

## KiCad design flight-module/Power-board/Power-board.kicad_pcb (2024-02-25)

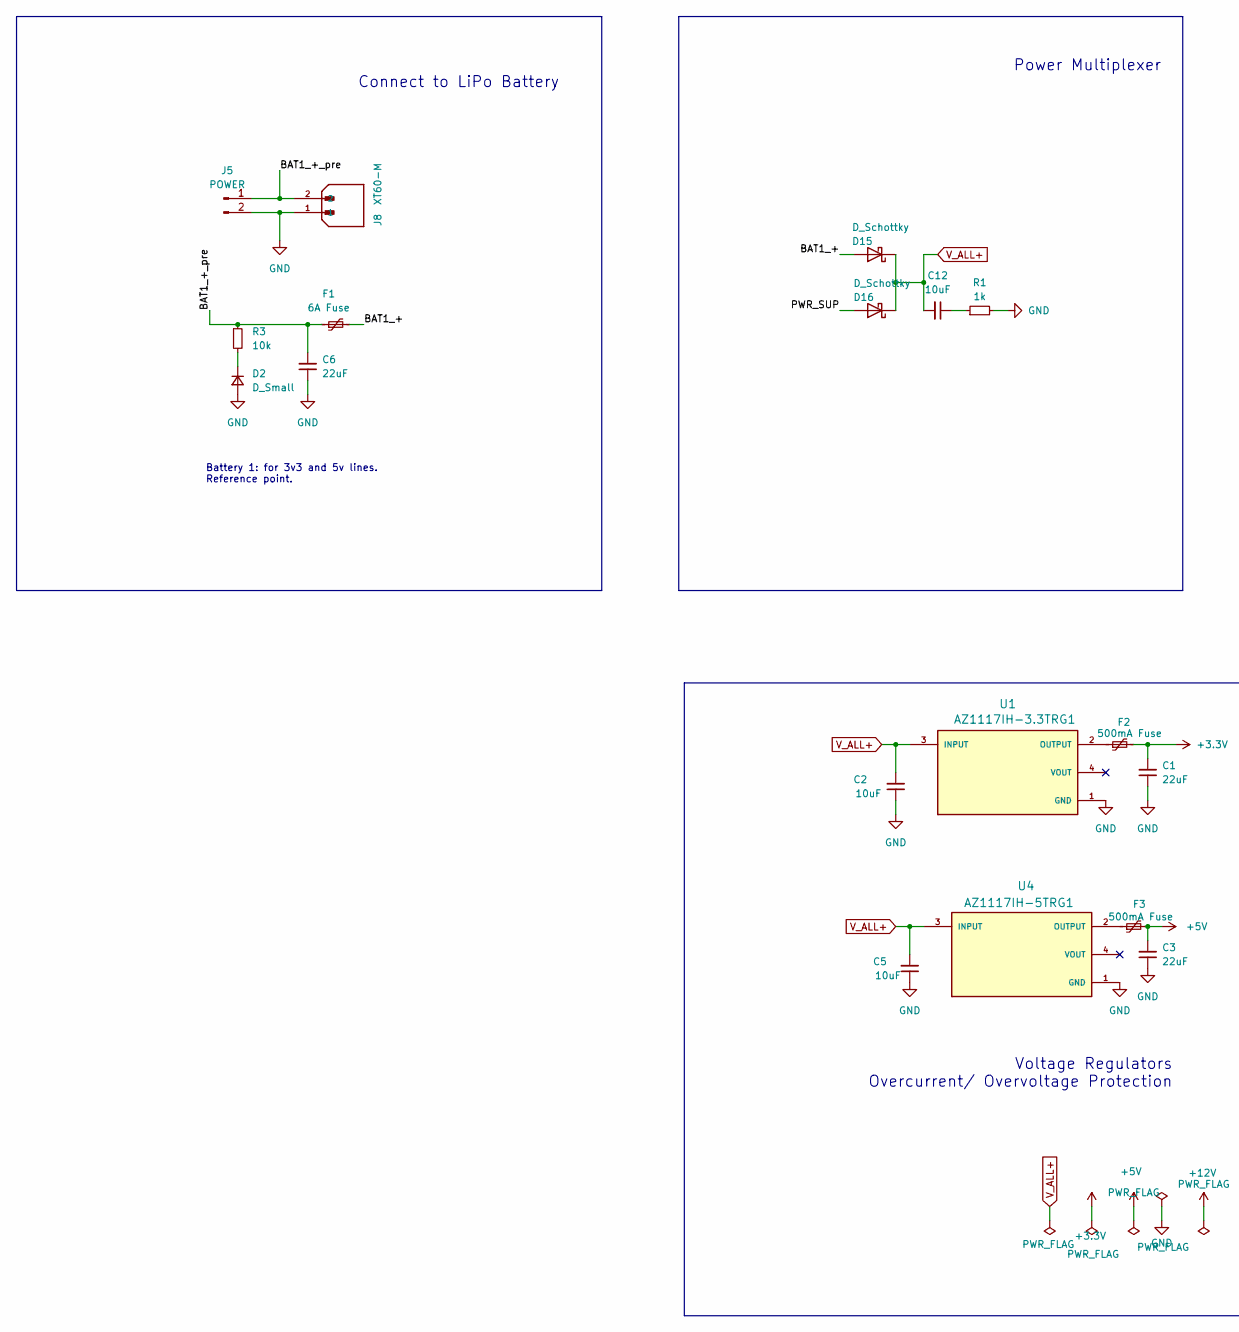
[picture p21: schematic Power-board.kicad_sch, part in row 1, column 1]

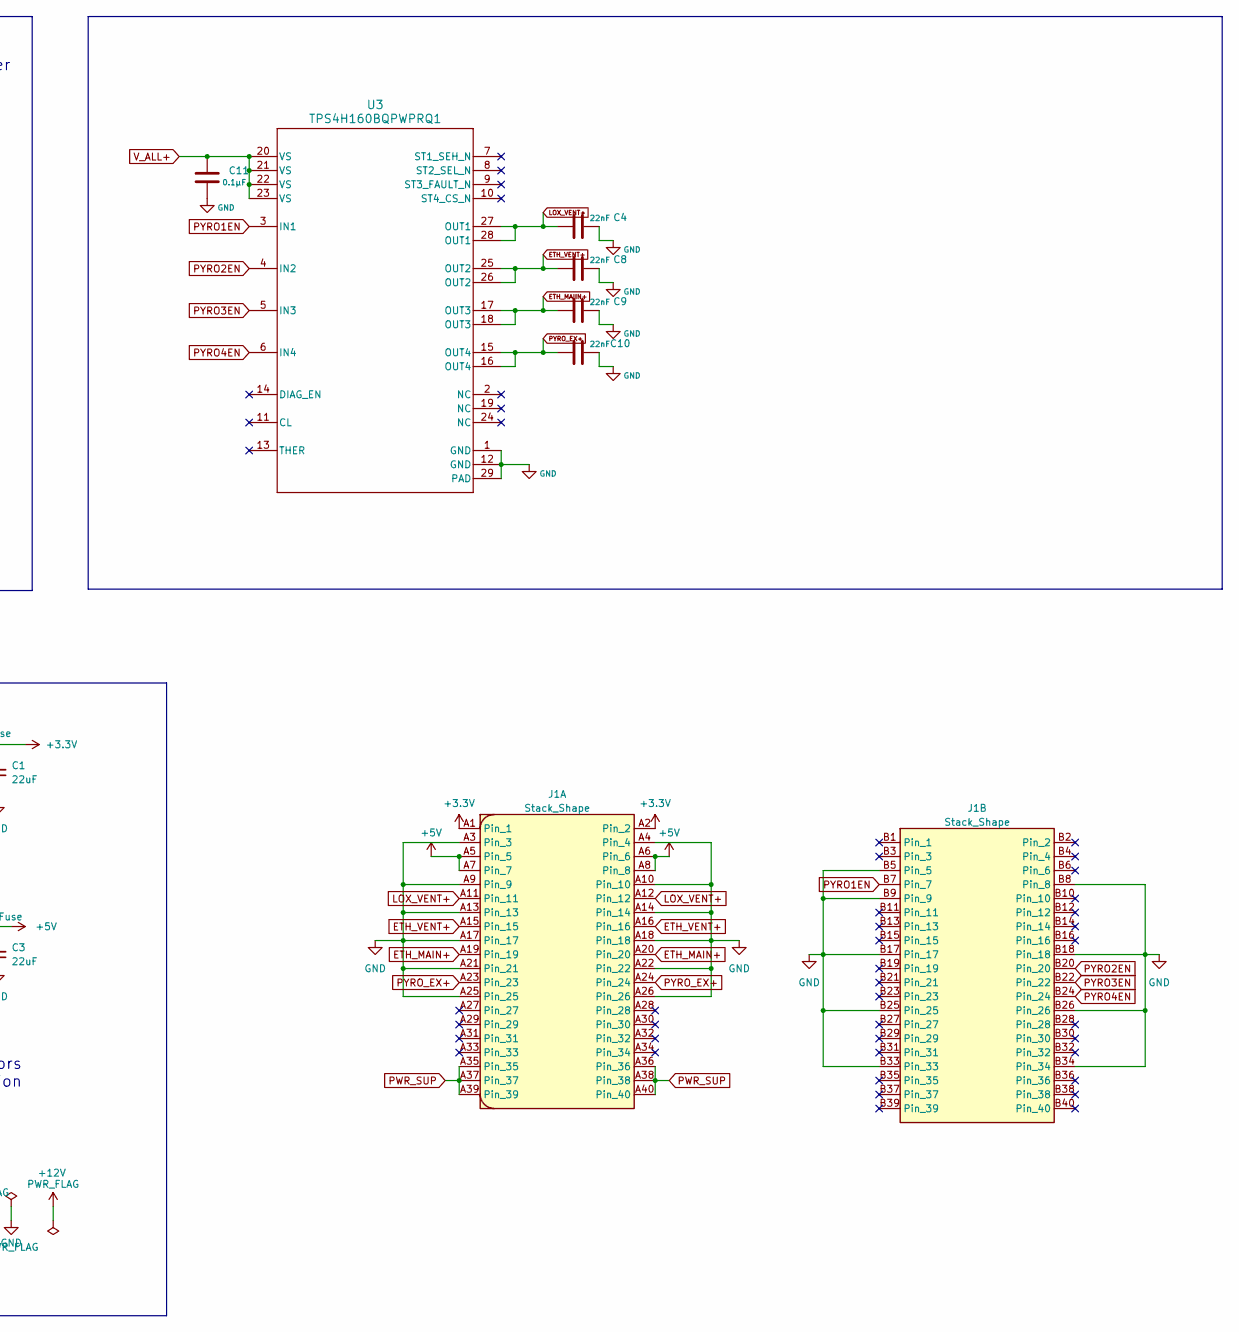
[picture p22: schematic Power-board.kicad_sch, part in row 1, column 2]

Parts:
C1, C3, C6: 22uF; C_0603_1608Metric
C2, C5, C12: 10uF; C_0603_1608Metric
C4, C8, C9, C10: 22nF; C_0603_1608Metric
C11: 0.1µF; C_0603_1608Metric
D2: D_Small; D_0603_1608Metric
D15, D16: D_Schottky; SMADO-214AC_LEAD-FRAME_MCC
F1: 6A Fuse; Fuse_2920_7451Metric
F2, F3: 500mA Fuse; Fuse_0603_1608Metric
J1: Stack_Shape
J5: POWER; Banana_Jack_2Pin
J8: XT60-M; AMASS_XT60PW-F_1x02_P7.20mm_Horizontal; PARTREV V1.2
R1: 1k; R_0603_1608Metric
R3: 10k; R_0603_1608Metric
U1: AZ1117IH-3.3TRG1; SOT223_AZ1117I_6P5X3P5_DIO; PARTREV 2-2
U3: TPS4H160BQPWPRQ1; PWP0028C_N
U4: AZ1117IH-5TRG1; SOT223_AZ1117I_6P5X3P5_DIO; PARTREV 2-2

Connections:
+3.3V: C1.2, F2.2, J1.A1 (Pin_1), J1.A2 (Pin_2)
+5V: C3.2, F3.2, J1.A5 (Pin_5), J1.A6 (Pin_6), J1.A7 (Pin_7), J1.A8 (Pin_8)
/BAT1_+: D15.2 (A), F1.2
/BAT1_+_pre: C6.2, F1.1, J5.1, J8.2, R3.1
ETH_MAIIN+: C9.1, U3.17 (OUT3), U3.18 (OUT3)
ETH_MAIN+: J1.A19 (Pin_19), J1.A20 (Pin_20)
ETH_VENT+: C8.1, J1.A15 (Pin_15), J1.A16 (Pin_16), U3.25 (OUT2), U3.26 (OUT2)
GND: C1.1, C2.1, C3.1, C4.2, C5.1, C6.1, C8.2, C9.2, C10.2, C11.2, D2.2 (A), J1.A3 (Pin_3), J1.A4 (Pin_4), J1.A9 (Pin_9), J1.A10 (Pin_10), J1.A13 (Pin_13), J1.A14 (Pin_14), J1.A17 (Pin_17), J1.A18 (Pin_18), J1.A21 (Pin_21), J1.A22 (Pin_22), J1.A25 (Pin_25), J1.A26 (Pin_26), J1.B5 (Pin_5), J1.B8 (Pin_8), J1.B9 (Pin_9), J1.B17 (Pin_17), J1.B18 (Pin_18), J1.B25 (Pin_25), J1.B26 (Pin_26), J1.B33 (Pin_33), J1.B34 (Pin_34), J5.2, J8.1, R1.2, U1.1 (GND), U3.1 (GND), U3.12 (GND), U3.29 (PAD), U4.1 (GND)
LOX_VENT+: C4.1, J1.A11 (Pin_11), J1.A12 (Pin_12), U3.27 (OUT1), U3.28 (OUT1)
unnamed: C12.1, R1.1
unnamed: D2.1 (K), R3.2
unnamed: F2.1, U1.2 (OUTPUT)
unnamed: F3.1, U4.2 (OUTPUT)
PWR_SUP: D16.2 (A), J1.A35 (Pin_35), J1.A36 (Pin_36), J1.A37 (Pin_37), J1.A38 (Pin_38), J1.A39 (Pin_39), J1.A40 (Pin_40)
PYRO1EN: J1.B7 (Pin_7), U3.3 (IN1)
PYRO2EN: J1.B20 (Pin_20), U3.4 (IN2)
PYRO3EN: J1.B22 (Pin_22), U3.5 (IN3)
PYRO4EN: J1.B24 (Pin_24), U3.6 (IN4)
PYRO_EX+: C10.1, J1.A23 (Pin_23), J1.A24 (Pin_24), U3.15 (OUT4), U3.16 (OUT4)
V_ALL+: C2.2, C5.2, C11.1, C12.2, D15.1 (K), D16.1 (K), U1.3 (INPUT), U3.20 (VS), U3.21 (VS), U3.22 (VS), U3.23 (VS), U4.3 (INPUT)

Notes on the sheet:
Power Multiplexer
Battery 1: for 3v3 and 5v lines. Reference point.
Voltage Regulators Overcurrent/ Overvoltage Protection
Connect to LiPo Battery

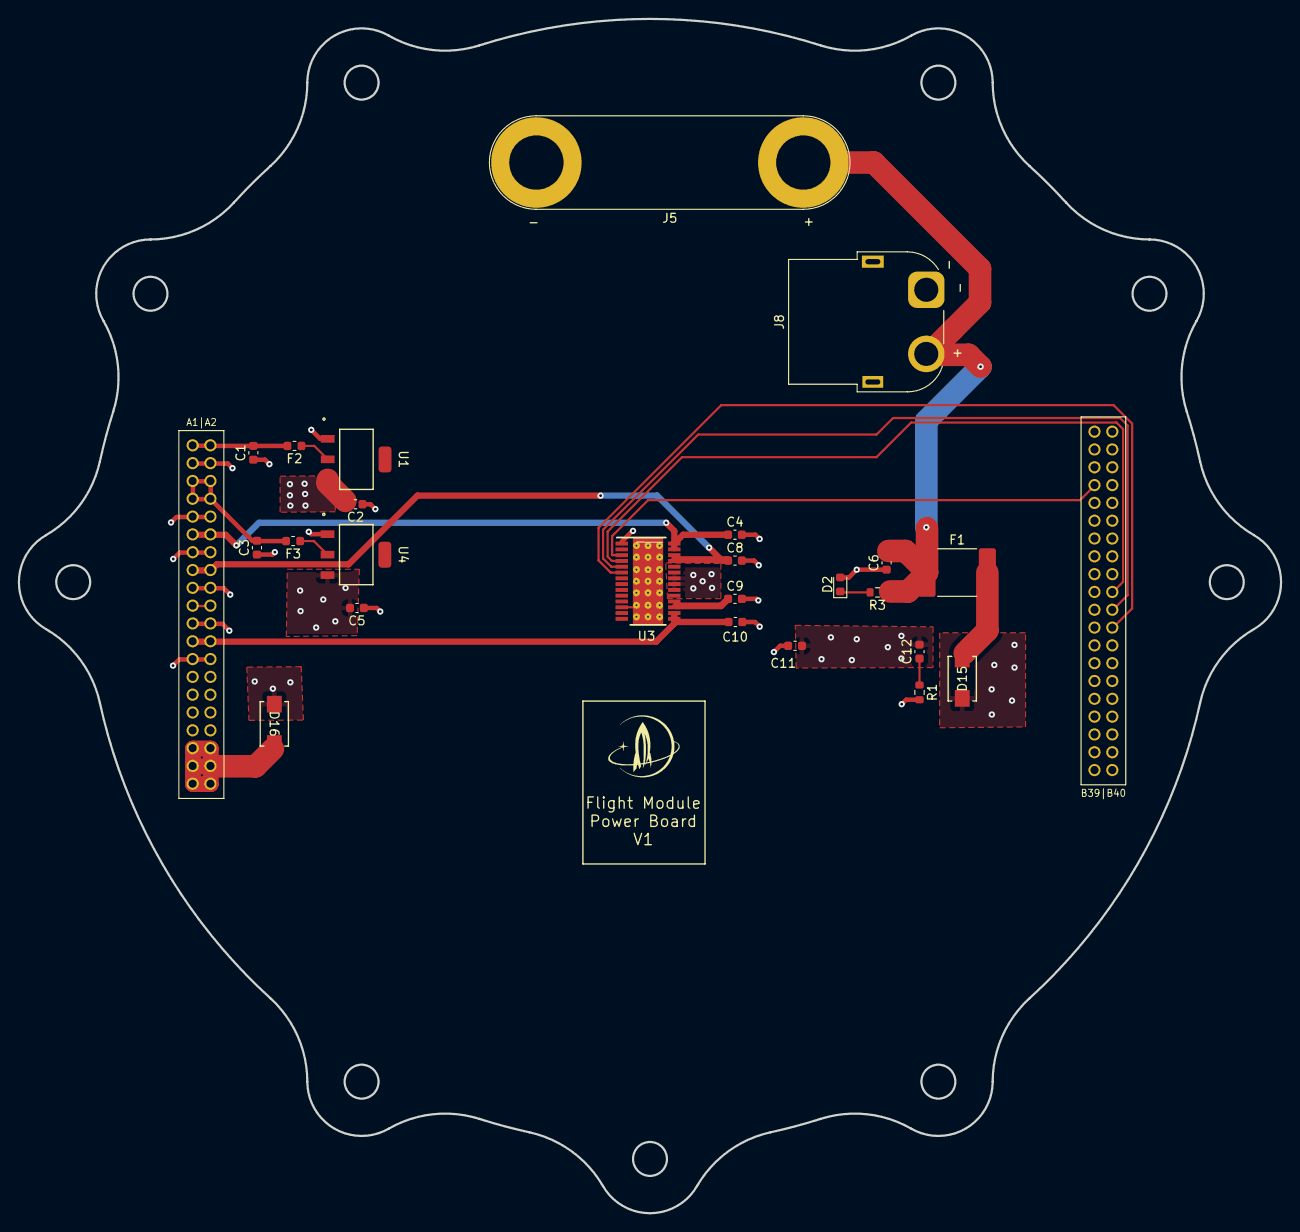
[picture p23: board Power-board.kicad_pcb from above]

Board: 4 copper layers, 141.7 x 134.1 mm, 25 parts (0 on the bottom side), 20 nets.
