calstar/le2-pcb-hardware/com-module/COM-Board/COM-Board.kicad_pcb

## KiCad design com-module/COM-Board/COM-Board.kicad_pcb (2024-01-27)

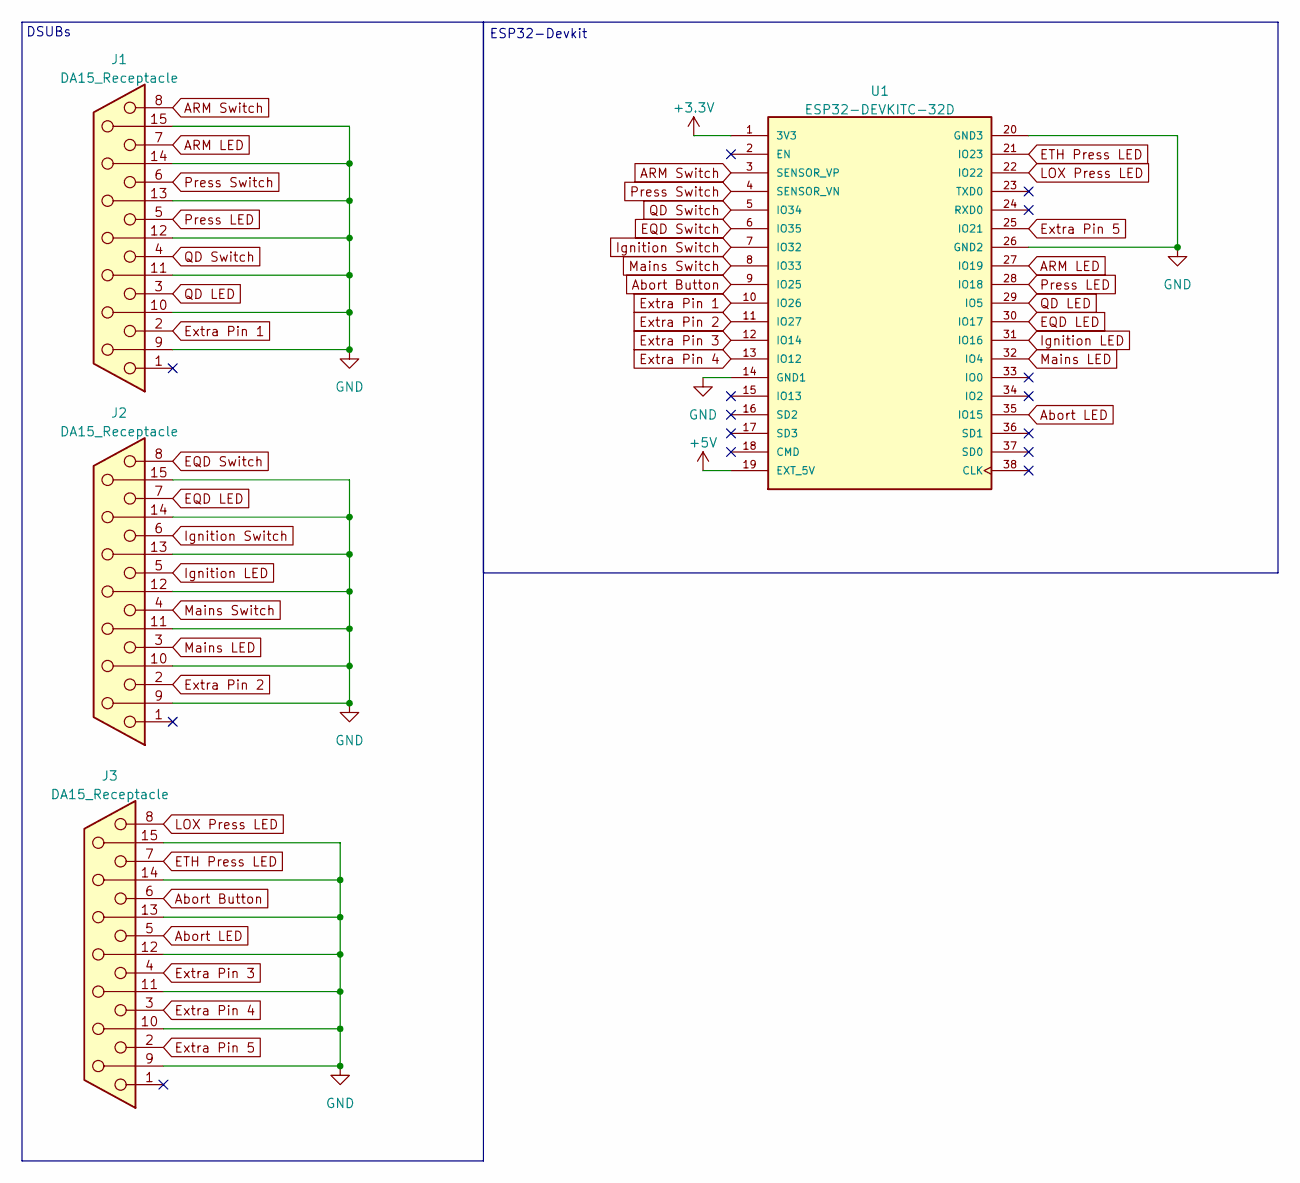
[picture p24: schematic COM-Board.kicad_sch]

Parts:
J1, J2, J3: DA15_Receptacle; DSUB-15_Female_Vertical_P2.77x2.84mm_MountingHoles
U1: ESP32-DEVKITC-32D; MODULE_ESP32-DEVKITC-32D; PARTREV 4

Connections:
+3.3V: U1.1 (3V3)
+5V: U1.19 (EXT_5V)
ARM LED: J1.7, U1.27 (IO19)
ARM Switch: J1.8, U1.3 (SENSOR_VP)
Abort Button: J3.6, U1.9 (IO25)
Abort LED: J3.5, U1.35 (IO15)
EQD LED: J2.7, U1.30 (IO17)
EQD Switch: J2.8, U1.6 (IO35)
ETH Press LED: J3.7, U1.21 (IO23)
Extra Pin 1: J1.2, U1.10 (IO26)
Extra Pin 2: J2.2, U1.11 (IO27)
Extra Pin 3: J3.4, U1.12 (IO14)
Extra Pin 4: J3.3, U1.13 (IO12)
Extra Pin 5: J3.2, U1.25 (IO21)
GND: J1.9, J1.10, J1.11 (P111), J1.12, J1.13, J1.14, J1.15, J2.9, J2.10, J2.11 (P111), J2.12, J2.13, J2.14, J2.15, J3.9, J3.10, J3.11 (P111), J3.12, J3.13, J3.14, J3.15, U1.14 (GND1), U1.20 (GND3), U1.26 (GND2)
Ignition LED: J2.5, U1.31 (IO16)
Ignition Switch: J2.6, U1.7 (IO32)
LOX Press LED: J3.8, U1.22 (IO22)
Mains LED: J2.3, U1.32 (IO4)
Mains Switch: J2.4, U1.8 (IO33)
Press LED: J1.5, U1.28 (IO18)
Press Switch: J1.6, U1.4 (SENSOR_VN)
QD LED: J1.3, U1.29 (IO5)
QD Switch: J1.4, U1.5 (IO34)

Notes on the sheet:
DSUBs
ESP32-Devkit
