calstar/le2-pcb-hardware/com-module/COM-Board/COM-Board.kicad_pcb

## KiCad design com-module/COM-Board/COM-Board.kicad_pcb (continued)

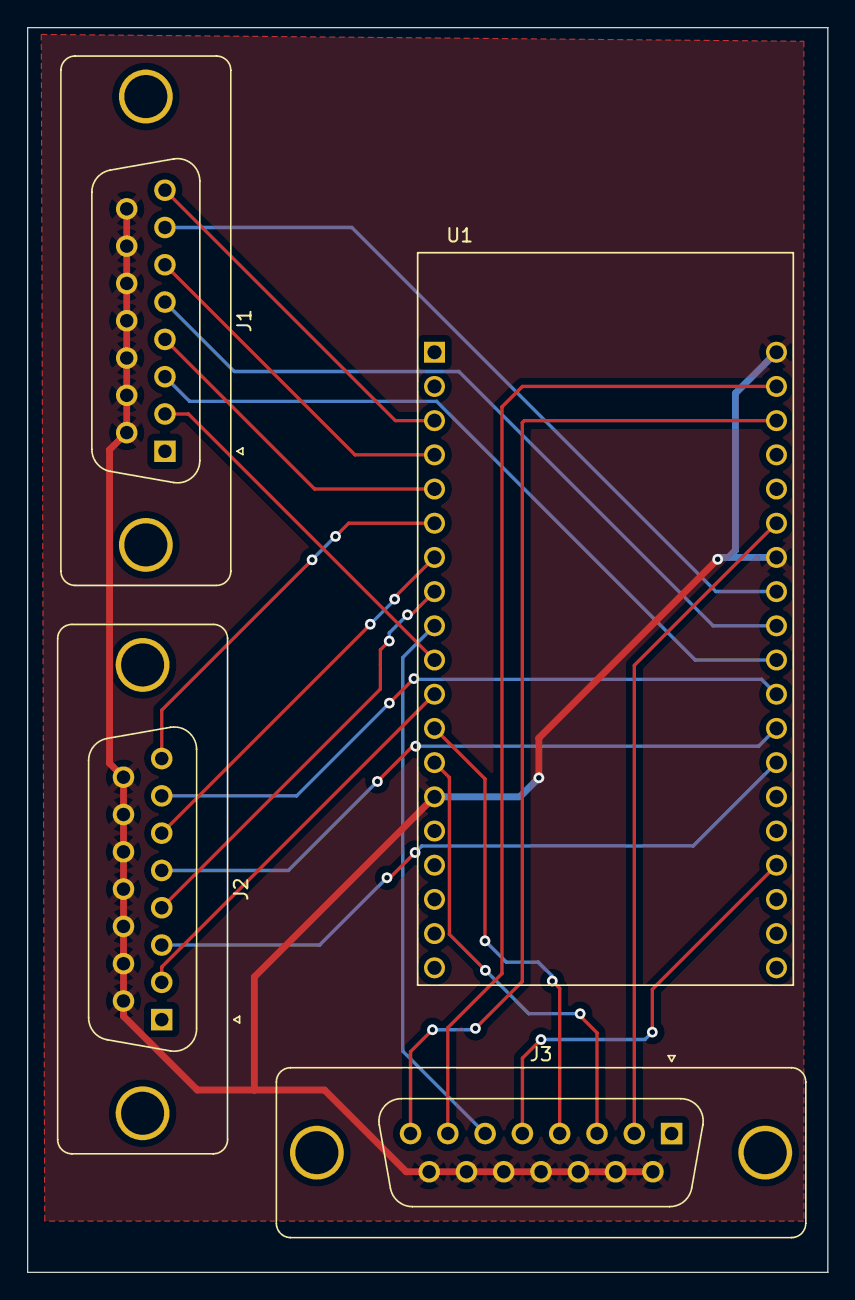
[picture p25: board COM-Board.kicad_pcb from above]

Board: 2 copper layers, 59.4 x 92.5 mm, 4 parts (0 on the bottom side), 22 nets.
