calstar/le2-pcb-hardware/ground-module/TC-board/TC-board.kicad_pcb

## KiCad design ground-module/TC-board/TC-board.kicad_pcb (2023-09-28)

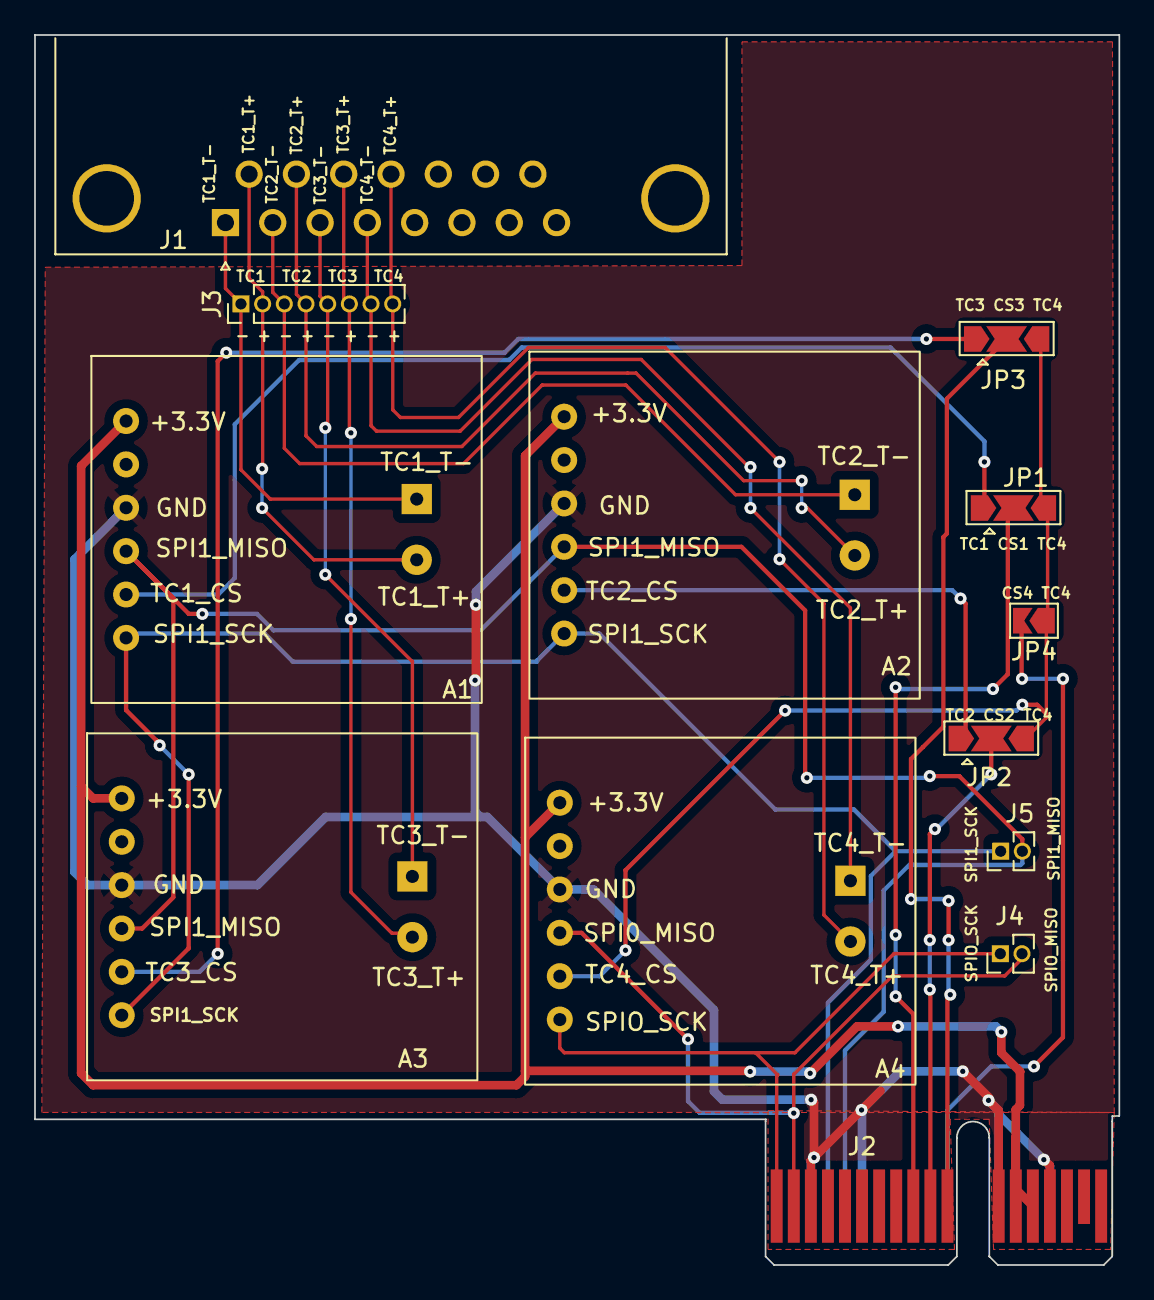
[picture p26: board TC-board.kicad_pcb from above]

Board: 2 copper layers, 63.5 x 72.0 mm, 13 parts (0 on the bottom side), 22 nets.

Parts:
A1, A2, A3, A4: MAX31855_Breakout
J1: DB15_Female; DSUB_622-015-260-042
J2: PCIE-LP-01-01-F-DV-A-TR; BUS_PCIexpress_x1
J3: Conn_01x08_Male; PinHeader_1x08_P1.27mm_Vertical
J4, J5: Conn_01x02_Male; PinHeader_1x02_P1.27mm_Vertical
JP1, JP2, JP3: SolderJumper_3_Open; SolderJumper-3_P2.0mm_Open_TrianglePad1.0x1.5mm
JP4: SolderJumper_2_Open; SolderJumper-2_P1.3mm_Open_TrianglePad1.0x1.5mm

Connections:
+3.3V: A1.4 (VIN), A2.4 (VIN), A3.4 (VIN), A4.4 (VIN), J2.B13, J2.B14
/CS1: J2.B9, JP1.2 (C)
/CS2: J2.B10, JP2.2 (C)
/CS3: J2.B11, JP3.2 (C)
/CS4: J2.A11, JP4.2 (B)
/SPI0_MISO: A4.7 (SDO), J2.B2, J4.2
/SPI0_SCK: A4.5 (SCK), J2.B1, J4.1
/SPI1_MISO: A1.7 (SDO), A2.7 (SDO), A3.7 (SDO), J2.A5, J5.2
/SPI1_SCK: A1.5 (SCK), A2.5 (SCK), A3.5 (SCK), J2.A4, J5.1
/TC1_CS: A1.6 (CS), JP1.1 (A)
/TC1_T+: A1.3 (T+), J1.9, J3.2
/TC1_T-: A1.2 (T-), J1.1, J3.1
/TC2_CS: A2.6 (CS), JP2.1 (A)
/TC2_T+: A2.3 (T+), J1.10, J3.4
/TC2_T-: A2.2 (T-), J1.2, J3.3
/TC3_CS: A3.6 (CS), JP3.1 (A)
/TC3_T+: A3.3 (T+), J1.11 (P111), J3.6
/TC3_T-: A3.2 (T-), J1.3, J3.5
/TC4_CS: A4.6 (CS), JP1.3 (B), JP2.3 (B), JP3.3 (B), JP4.1 (A)
/TC4_T+: A4.3 (T+), J1.12, J3.8
/TC4_T-: A4.2 (T-), J1.4, J3.7
GND: A1.1 (GND), A2.1 (GND), A3.1 (GND), A4.1 (GND), J2.A3, J2.A6, J2.A12, J2.A15, J2.B3, J2.B12, J2.B15
