calstar/le2-pcb-hardware/ground-module/Core-Board/Core-Board.kicad_pcb

## KiCad design ground-module/Core-Board/Core-Board.kicad_pcb (2023-09-15)

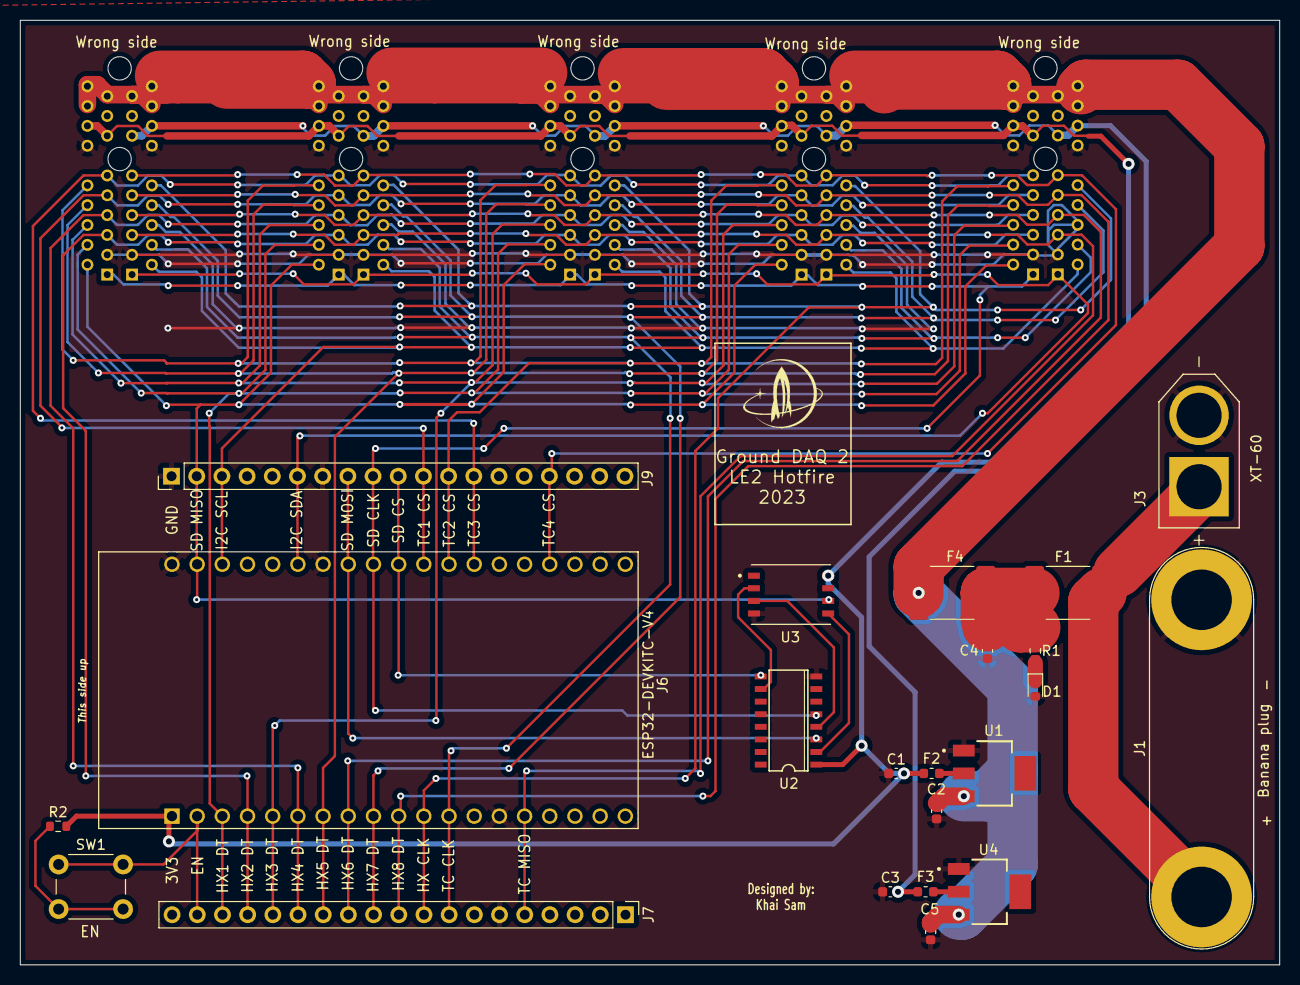
[picture p27: board ground-module/Core-Board/Core-Board.kicad_pcb from above]

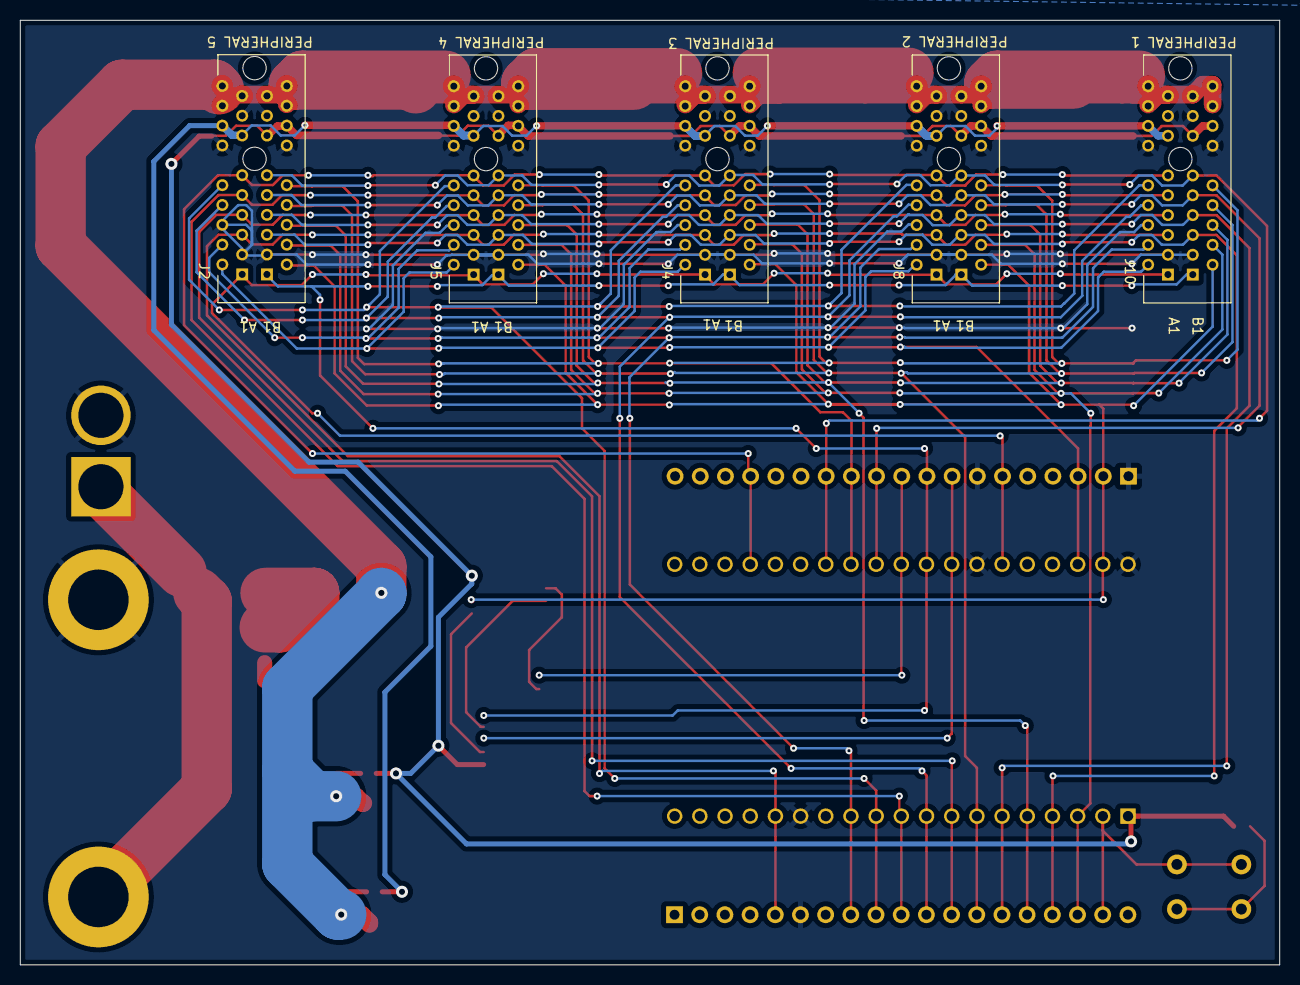
[picture p28: board ground-module/Core-Board/Core-Board.kicad_pcb from below]

Board: 2 copper layers, 127.0 x 95.2 mm, 27 parts (5 on the bottom side), 35 nets.

Parts:
C1, C3, C4: 22uF; C_0603_1608Metric
C2, C5: 10uF; C_0603_1608Metric
D1: D_Small; D_0603_1608Metric
F1, F4: 6A Fuse; Fuse_2920_7451Metric
F2, F3: 500mA Fuse; Fuse_0603_1608Metric
J1: POWER; Banana_Jack_2Pin
J2, J4, J5, J8, J10: PCIE; AMPHENOL_10018784-10210TLF
J3: XT60-M; AMASS_XT60-M
J6: ESP32-DEVKITC-32D; MODULE_ESP32-DEVKITC-32D
J7, J9: Conn_01x19_Male; PinHeader_1x19_P2.54mm_Vertical
R1: 10k; R_0603_1608Metric
R2: 1k; R_0603_1608Metric
SW1: SW_SPST; SW_PUSH_6mm
U1: AZ1117IH-3.3TRG1; SOT230P700X185-4N
U2: 74HC4050D; SO16
U3: XTSD04GLGEAG; SON127P600X800X95-8N
U4: AZ1117IH-5TRG1; SOT230P700X185-4N

Connections:
3.3V: C1.2, F2.2, J2.B13, J2.B14, J4.B13, J4.B14, J5.B13, J5.B14, J6.1 (3V3), J8.B13, J8.B14, J10.B13, J10.B14, R2.2, U2.1 (VCC), U3.8 (VDD)
5V: C3.2, F3.2, J2.A13, J2.A14, J4.A13, J4.A14, J5.A13, J5.A14, J8.A13, J8.A14, J10.A13, J10.A14
12V: C2.2, C5.2, F4.2, J2.A16, J2.A17, J2.A18, J2.B16, J2.B17, J2.B18, J4.A16, J4.A17, J4.A18, J4.B16, J4.B17, J4.B18, J5.A16, J5.A17, J5.A18, J5.B16, J5.B17, J5.B18, J8.A16, J8.A17, J8.A18, J8.B16, J8.B17, J8.B18, J10.A16, J10.A17, J10.A18, J10.B16, J10.B17, J10.B18, U1.3 (INPUT), U4.3 (INPUT)
+12V: F1.1, J1.1, J3.P (POS)
EN: J6.2 (EN), J7.18, SW1.1 (A)
GND: C1.1, C2.1, C3.1, C4.1, C5.1, D1.2 (A), J1.2, J2.A3, J2.A6, J2.A12, J2.A15, J2.B3, J2.B12, J2.B15, J3.N (NEG), J4.A3, J4.A6, J4.A12, J4.A15, J4.B3, J4.B12, J4.B15, J5.A3, J5.A6, J5.A12, J5.A15, J5.B3, J5.B12, J5.B15, J6.14 (GND1), J6.20 (GND3), J6.26 (GND2), J7.6, J8.A3, J8.A6, J8.A12, J8.A15, J8.B3, J8.B12, J8.B15, J9.1, J9.7, J10.A3, J10.A6, J10.A12, J10.A15, J10.B3, J10.B12, J10.B15, U1.1 (GND), U2.8 (GND), U3.4 (VSS), U4.1 (GND)
HX1: J2.B4, J4.B4, J5.B4, J6.3 (SENSOR_VP), J7.17, J8.B4, J10.B4
HX2: J2.B5, J4.B5, J5.B5, J6.4 (SENSOR_VN), J7.16, J8.B5, J10.B5
HX3: J2.B6, J4.B6, J5.B6, J6.5 (IO34), J7.15, J8.B6, J10.B6
HX4: J2.B7, J4.B7, J5.B7, J6.6 (IO35), J7.14, J8.B7, J10.B7
HX5: J2.B8, J4.B8, J5.B8, J6.7 (IO32), J7.13, J8.B8, J10.B8
HX6: J2.A7, J4.A7, J5.A7, J6.8 (IO33), J7.12, J8.A7, J10.A7
HX7: J2.A8, J4.A8, J5.A8, J6.9 (IO25), J7.11, J8.A8, J10.A8
HX8: J2.A9, J4.A9, J5.A9, J6.10 (IO26), J7.10, J8.A9, J10.A9
HX CLK: J2.A10, J4.A10, J5.A10, J6.11 (IO27), J7.9, J8.A10, J10.A10
MOS SCL: J2.A2, J4.A2, J5.A2, J6.22 (IO22), J8.A2, J9.3, J10.A2
MOS SDA: J2.A1, J4.A1, J5.A1, J6.25 (IO21), J8.A1, J9.6, J10.A1
unnamed: C4.2, F1.2, F4.1, R1.1
unnamed: D1.1 (K), R1.2
unnamed: F2.1, U1.2 (OUTPUT)
unnamed: F3.1, U4.2 (OUTPUT)
unnamed: R2.1, SW1.2 (B)
SD CLK_3.3: U2.4 (2Y), U3.3 (CLK)
SD CS: J6.29 (IO5), J9.10, U2.9 (4A)
SD CS_3.3: U2.10 (4Y), U3.2 (SD3/~CS)
SD MOSI: J6.27 (IO19), J9.8, U2.3 (1A)
SD MOSI_3.3: U2.2 (1Y), U3.5 (CMD/DI)
SD, TC CLK: J2.B1, J4.B1, J5.B1, J6.28 (IO18), J8.B1, J9.9, J10.B1, U2.5 (2A)
SD, TC MISO: J2.B2, J4.B2, J5.B2, J6.21 (IO23), J8.B2, J9.2, J10.B2, U3.6 (SD0/DO)
TC1: J2.B9, J4.B9, J5.B9, J6.30 (IO17), J8.B9, J9.11, J10.B9
TC2: J2.B10, J4.B10, J5.B10, J6.31 (IO16), J8.B10, J9.12, J10.B10
TC3: J2.B11, J4.B11, J5.B11, J6.32 (IO4), J8.B11, J9.13, J10.B11
TC4: J2.A11, J4.A11, J5.A11, J6.35 (IO15), J8.A11, J9.16, J10.A11
TC CLK: J2.A4, J4.A4, J5.A4, J6.12 (IO14), J7.8, J8.A4, J10.A4
TC MISO: J2.A5, J4.A5, J5.A5, J6.15 (IO13), J7.5, J8.A5, J10.A5
