calstar/le2-pcb-hardware/ground-module/MOSFET-board/MOSFET-board.kicad_pcb

## KiCad design ground-module/MOSFET-board/MOSFET-board.kicad_pcb (2024-01-27)

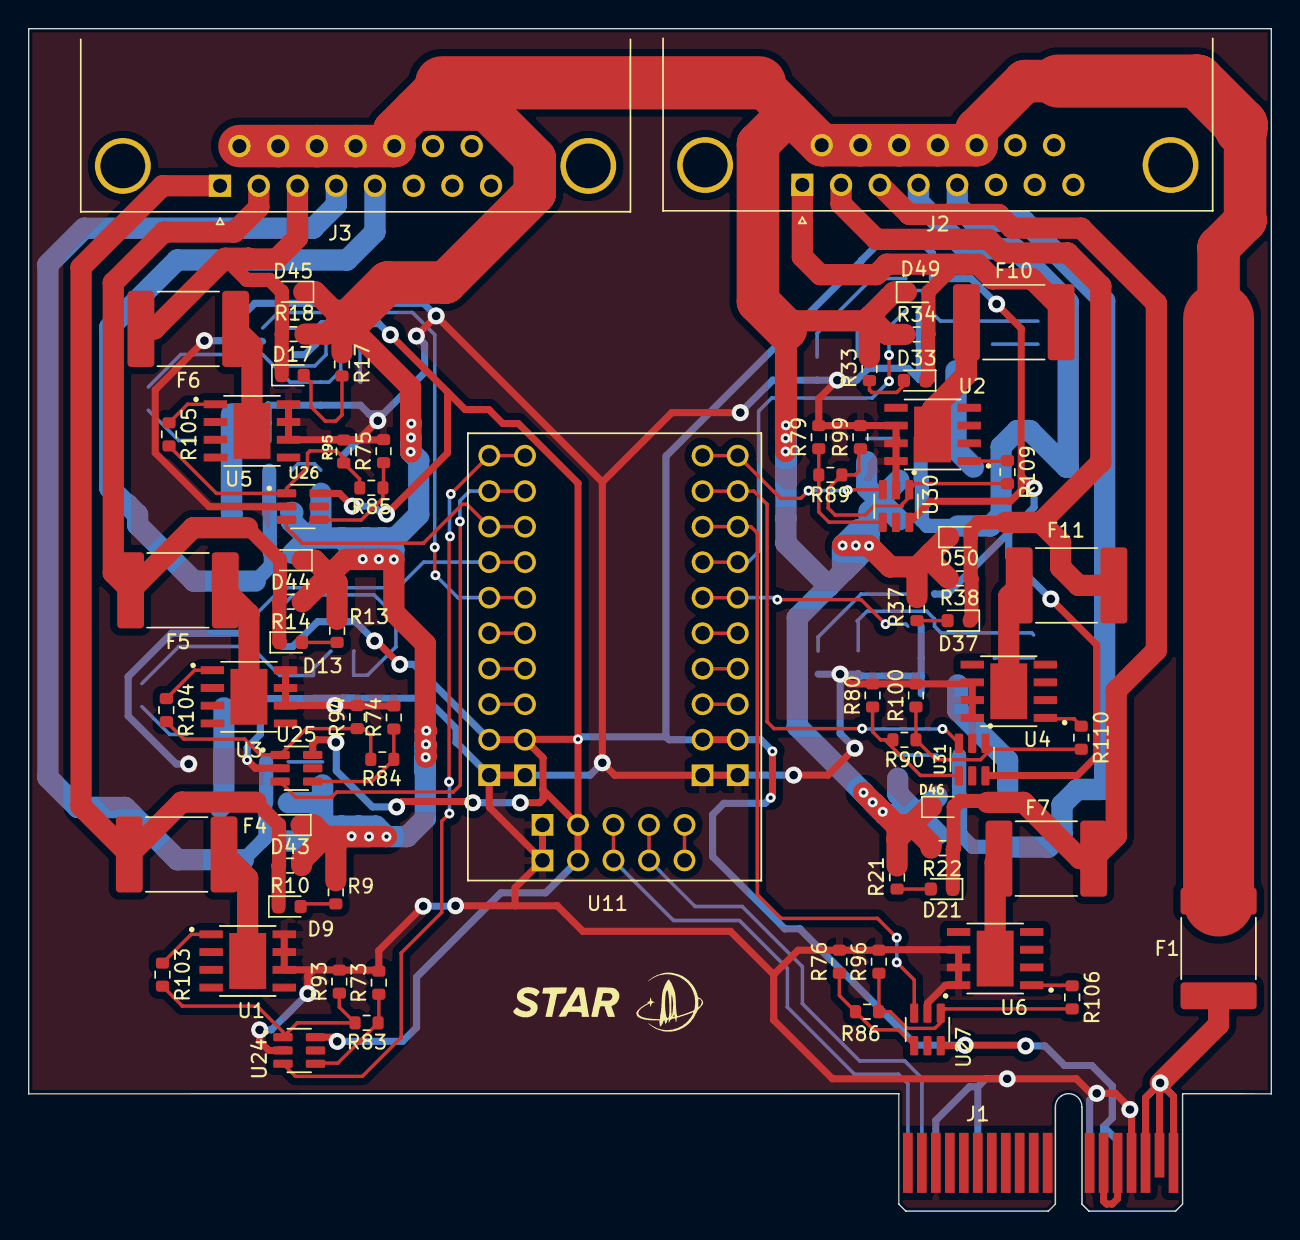
[picture p29: board MOSFET-board.kicad_pcb from above]

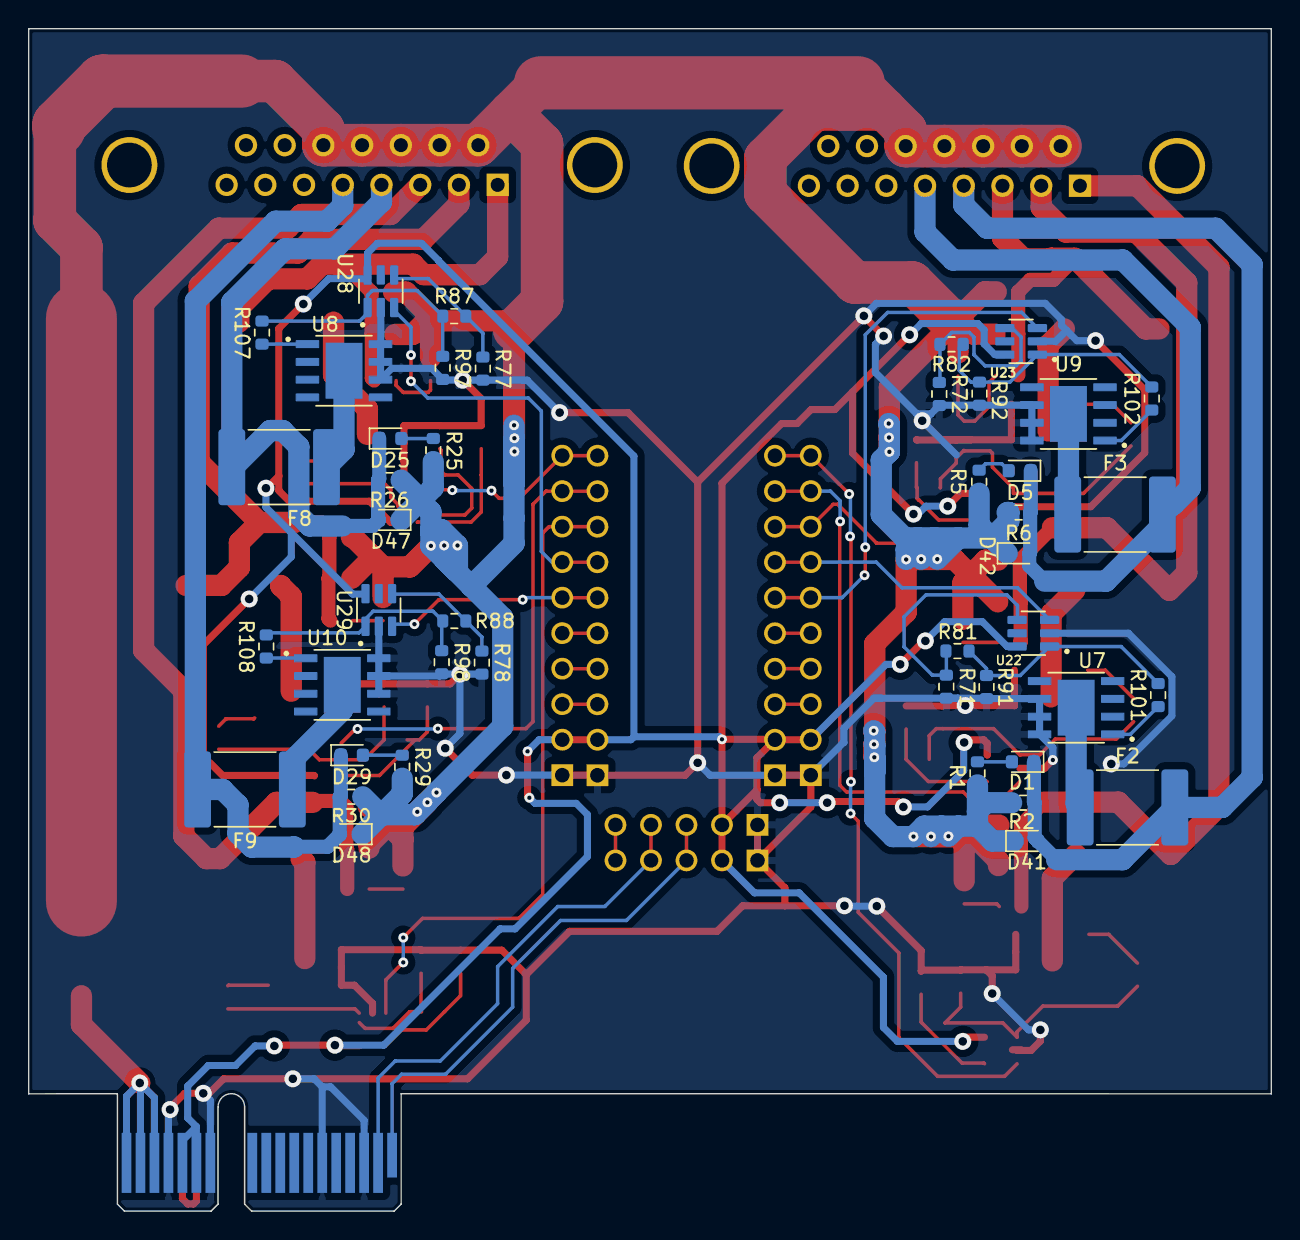
[picture p30: board MOSFET-board.kicad_pcb from below]

Board: 2 copper layers, 88.9 x 84.6 mm, 115 parts (44 on the bottom side), 77 nets.

Parts:
D1, D5, D9, D13, D17, D21, D25, D29, D33, D37: G_LED; LED_0603_1608Metric
D41, D42, D43, D44, D45, D46, D47, D48, D49, D50: D_Schottky; D_0603_1608Metric
F1: 6A Fuse; Fuse_2920_7451Metric
F2, F3, F4, F5, F6, F7, F8, F9, F10, F11: 3A Fuse; Fuse_2920_7451Metric
J1: PCIE-LP-01-01-F-DV-A-TR; BUS_PCIexpress_x1
J2, J3: DB15_Female; DSUB-15_Female_Horizontal_P2.77x2.84mm_EdgePinOffset7.70mm_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
R1, R5, R9, R13, R17, R21, R25, R29, R33, R37: 100; R_0603_1608Metric
R2, R6, R10, R14, R18, R22, R26, R30, R34, R38, R91, R92, R93, R94, R95, R96, R97, R98, R99, R100: 10k; R_0603_1608Metric
R71, R72, R73, R74, R75, R76, R77, R78, R79, R80: 1k; R_0603_1608Metric
R81, R82, R83, R84, R85, R86, R87, R88, R89, R90: 9k; R_0603_1608Metric
R101, R102, R103, R104, R105, R106, R107, R108, R109, R110: 2k; R_0603_1608Metric
U1, U2, U3, U4, U5, U6, U7, U8, U9, U10: BTS3080EJXUMA1; SOIC127P600X115-9N
U11: PCF8575_Breakout
U22, U23, U24, U25, U26, U27, U28, U29, U30, U31: ADA4897-1ARJZ-R7; SOT95P280X145-6N

Connections:
+3.3V: J1.B13, J1.B14
+5V: J1.A13, J1.A14, U11.9 (VDD), U11.12 (VCC), U11.17 (VDD), U22.6, U23.6, U24.6, U25.6, U26.6, U27.6, U28.6, U29.6, U30.6, U31.6
+12V: D41.1 (K), D42.1 (K), D43.1 (K), D44.1 (K), D45.1 (K), D46.1 (K), D47.1 (K), D48.1 (K), D49.1 (K), D50.1 (K), F1.2, J2.9, J2.10, J2.11 (P111), J2.12, J2.13, J3.9, J3.10, J3.11 (P111), J3.12, J3.13, R1.1, R2.1, R5.1, R6.1, R9.1, R10.1, R13.1, R14.1, R17.1, R18.1, R21.1, R22.1, R25.1, R26.1, R29.1, R30.1, R33.1, R34.1, R37.1, R38.1
GND: J1.A3, J1.A6, J1.A12, J1.A15, J1.B3, J1.B12, J1.B15, R71.2, R72.2, R73.2, R74.2, R75.2, R76.2, R77.2, R78.2, R79.2, R80.2, R91.2, R92.2, R93.2, R94.2, R95.2, R96.2, R97.2, R98.2, R99.2, R100.2, U1.6 (GND), U1.7 (GND), U1.8 (GND), U2.6 (GND), U2.7 (GND), U2.8 (GND), U3.6 (GND), U3.7 (GND), U3.8 (GND), U4.6 (GND), U4.7 (GND), U4.8 (GND), U5.6 (GND), U5.7 (GND), U5.8 (GND), U6.6 (GND), U6.7 (GND), U6.8 (GND), U7.6 (GND), U7.7 (GND), U7.8 (GND), U8.6 (GND), U8.7 (GND), U8.8 (GND), U9.6 (GND), U9.7 (GND), U9.8 (GND), U10.6 (GND), U10.7 (GND), U10.8 (GND), U11.10 (GND), U11.11 (GND), U11.16 (GND), U22.2, U23.2, U24.2, U25.2, U26.2, U27.2, U28.2, U29.2, U30.2, U31.2
I2C_SCL: J1.A2, U11.14 (SCL)
I2C_SDA: J1.A1, U11.13 (SDA)
unnamed: D1.2 (A), R1.2
unnamed: D5.2 (A), R5.2
unnamed: D9.2 (A), R9.2
unnamed: D13.2 (A), R13.2
unnamed: D17.2 (A), R17.2
unnamed: D21.2 (A), R21.2
unnamed: D25.2 (A), R25.2
unnamed: D29.2 (A), R29.2
unnamed: D33.2 (A), R33.2
unnamed: D37.2 (A), R37.2
unnamed: F1.1, J1.A16, J1.A17, J1.A18, J1.B16, J1.B17, J1.B18
unnamed: R71.1, R81.2, U22.4
unnamed: R72.1, R82.2, U23.4
unnamed: R73.1, R83.2, U24.4
unnamed: R74.1, R84.2, U25.4
unnamed: R75.1, R85.2, U26.4
unnamed: R76.1, R86.2, U27.4
unnamed: R77.1, R87.2, U28.4
unnamed: R78.1, R88.2, U29.4
unnamed: R79.1, R89.2, U30.4
unnamed: R80.1, R90.2, U31.4
unnamed: R90.1, R100.1, R110.2, U31.1
unnamed: R81.1, R91.1, R101.2, U22.1
unnamed: R82.1, R92.1, R102.2, U23.1
unnamed: R83.1, R93.1, R103.2, U24.1
unnamed: R84.1, R94.1, R104.2, U25.1
unnamed: R85.1, R95.1, R105.2, U26.1
unnamed: R86.1, R96.1, R106.2, U27.1
unnamed: R87.1, R97.1, R107.2, U28.1
unnamed: R88.1, R98.1, R108.2, U29.1
unnamed: R89.1, R99.1, R109.2, U30.1
unnamed: R103.1, U1.1 (IN)
unnamed: F4.1, U1.9 (OUT)
unnamed: R109.1, U2.1 (IN)
unnamed: F10.1, U2.9 (OUT)
unnamed: R104.1, U3.1 (IN)
unnamed: F5.1, U3.9 (OUT)
unnamed: R110.1, U4.1 (IN)
unnamed: F11.1, U4.9 (OUT)
unnamed: R105.1, U5.1 (IN)
unnamed: F6.1, U5.9 (OUT)
unnamed: R106.1, U6.1 (IN)
unnamed: F7.1, U6.9 (OUT)
unnamed: R101.1, U7.1 (IN)
unnamed: F2.1, U7.9 (OUT)
unnamed: R107.1, U8.1 (IN)
unnamed: F8.1, U8.9 (OUT)
unnamed: R102.1, U9.1 (IN)
unnamed: F3.1, U9.9 (OUT)
unnamed: R108.1, U10.1 (IN)
unnamed: F9.1, U10.9 (OUT)
PYRO1: D9.1 (K), D43.2 (A), F4.2, J3.1, R10.2
PYRO1EN: U11.1 (P10), U24.3
PYRO2: D33.1 (K), D49.2 (A), F10.2, J2.1, R34.2
PYRO2EN: U11.25 (P07), U30.3
PYRO3: D13.1 (K), D44.2 (A), F5.2, J3.2, R14.2
PYRO3EN: U11.2 (P11), U25.3
PYRO4: D37.1 (K), D50.2 (A), F11.2, J2.2, R38.2
PYRO4EN: U11.24 (P06), U31.3
PYRO5: D17.1 (K), D45.2 (A), F6.2, J3.3, R18.2
PYRO5EN: U11.3 (P12), U26.3
PYRO6: D21.1 (K), D46.2 (A), F7.2, J2.3, R22.2
PYRO6EN: U11.23 (P05), U27.3
PYRO7: D1.1 (K), D41.2 (A), F2.2, J3.4, R2.2
PYRO7EN: U11.4 (P13), U22.3
PYRO8: D25.1 (K), D47.2 (A), F8.2, J2.4, R26.2
PYRO8EN: U11.22 (P04), U28.3
PYRO9: D5.1 (K), D42.2 (A), F3.2, J3.5, R6.2
PYRO9EN: U11.5 (P14), U23.3
PYRO10: D29.1 (K), D48.2 (A), F9.2, J2.5, R30.2
PYRO10EN: U11.21 (P03), U29.3
