calstar/le2-pcb-hardware/ground-module/HX-board/HX-board.kicad_pcb

## KiCad design ground-module/HX-board/HX-board.kicad_pcb (2023-09-15)

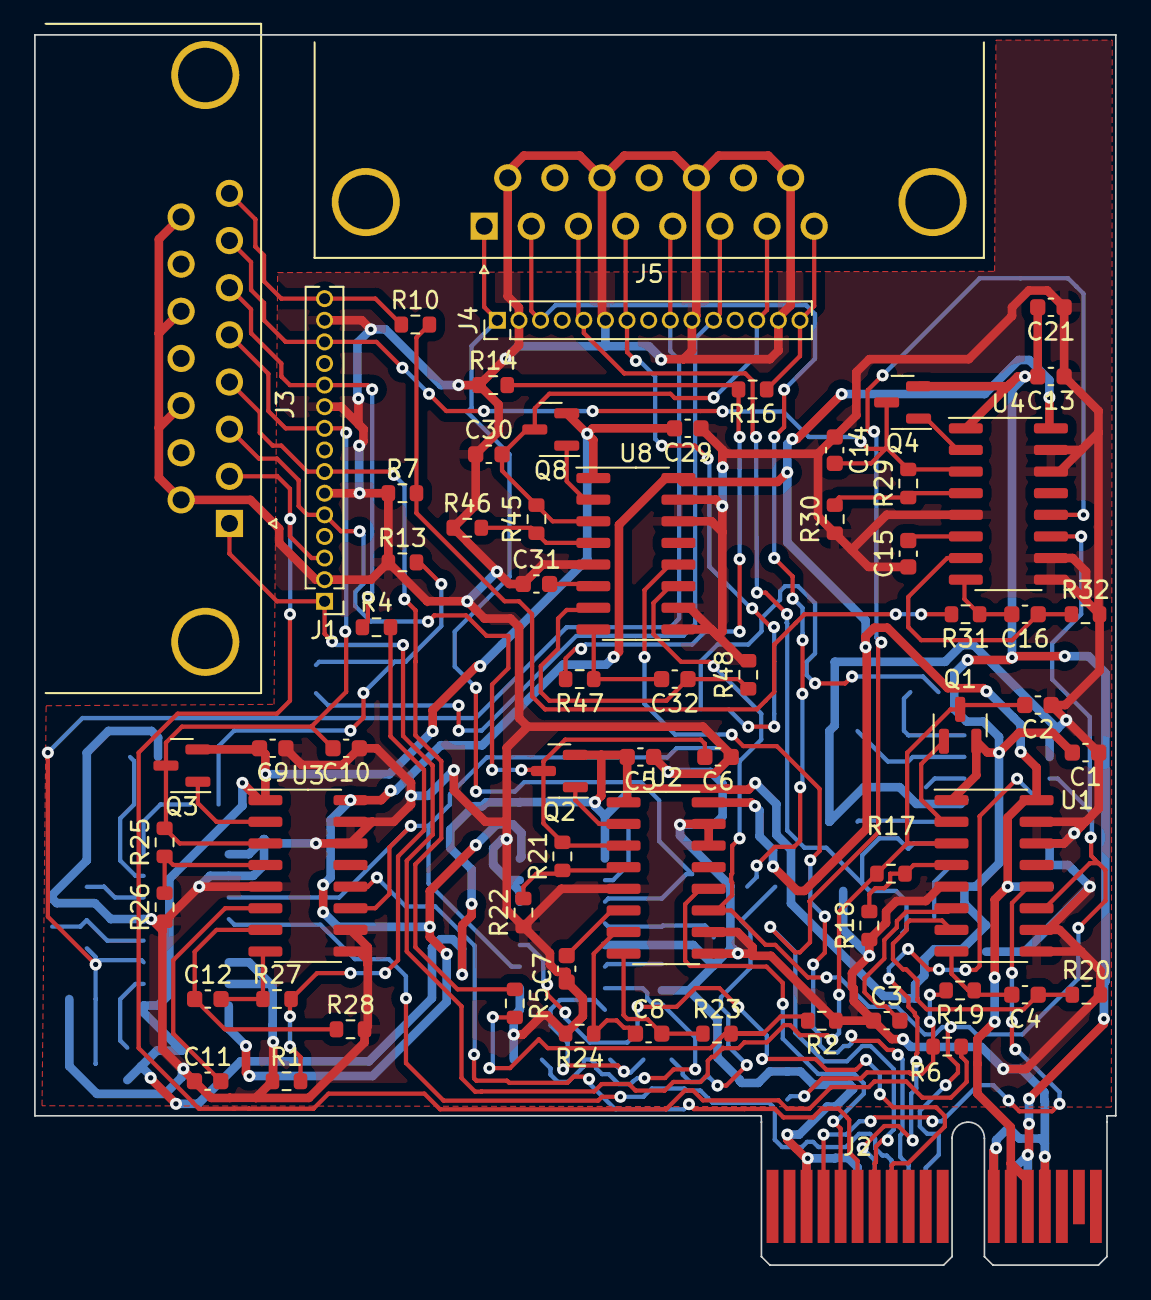
[picture p31: board HX-board.kicad_pcb from above]

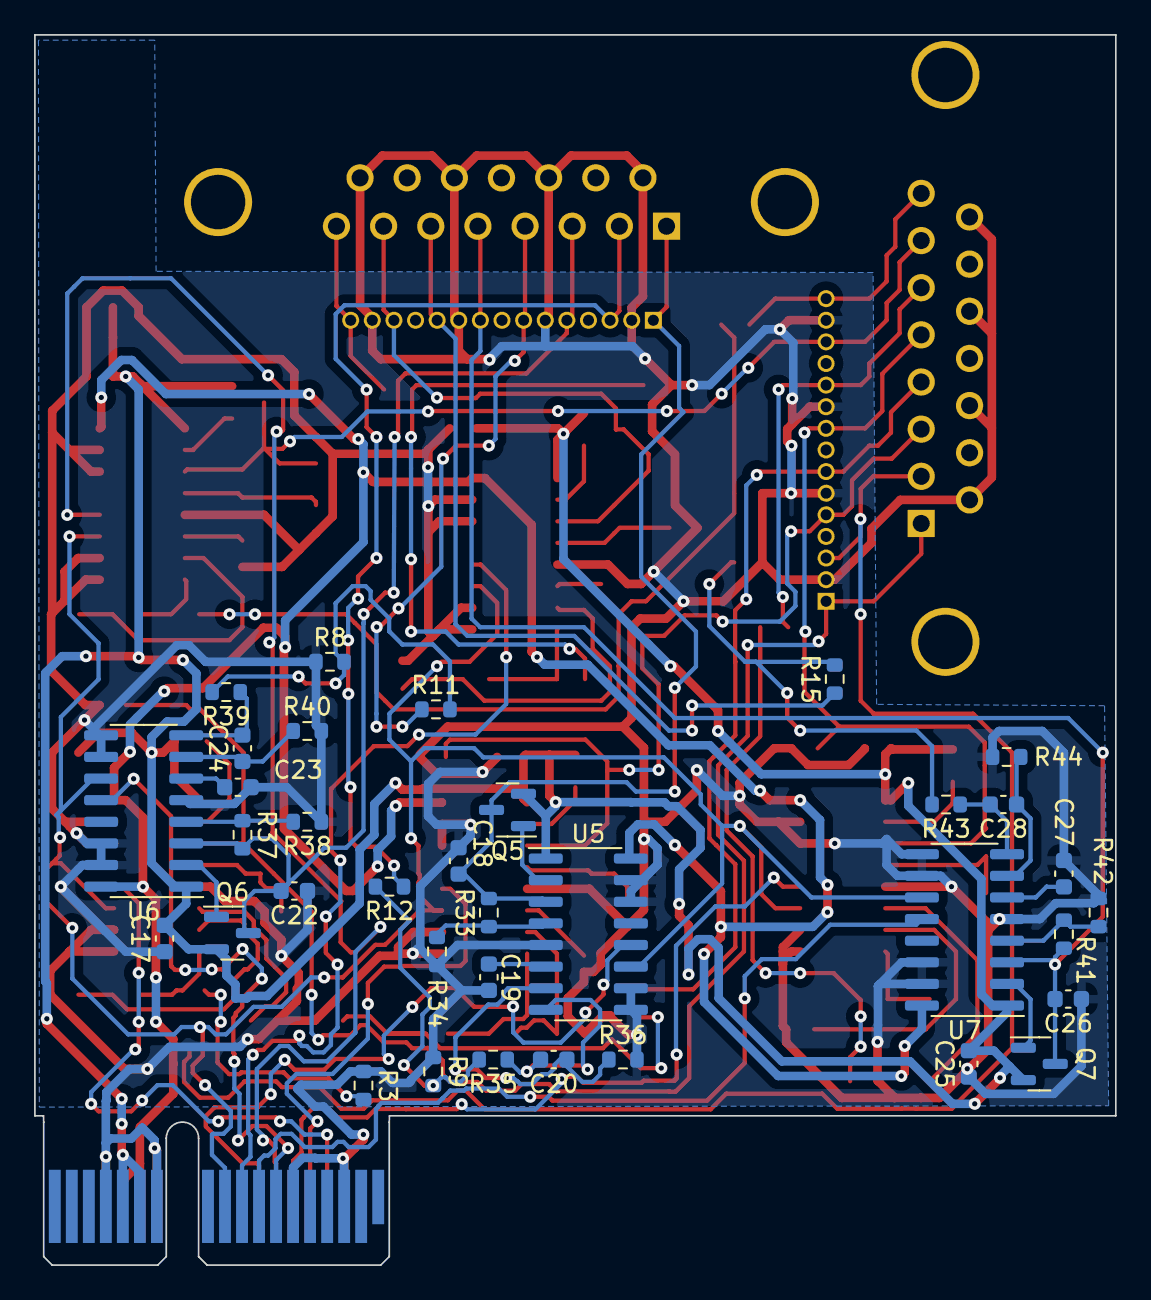
[picture p32: board HX-board.kicad_pcb from below]

Board: 2 copper layers, 63.5 x 72.3 mm, 101 parts (35 on the bottom side), 76 nets.

Parts:
C1, C2, C5, C6, C9, C10, C13, C14, C17, C18, C21, C22, C25, C26, C29, C30: 10uF; C_0603_1608Metric
C3, C4, C7, C8, C11, C12, C15, C16, C19, C20, C23, C24, C27, C28, C31, C32: 0.1uF; C_0603_1608Metric
J1, J4: Testpoints; PinHeader_1x15_P1.27mm_Vertical
J2: PCIE-LP-01-01-F-DV-A-TR; BUS_PCIexpress_x1
J3, J5: DB15_Female; DSUB_622-015-260-042
Q1, Q2, Q3, Q4, Q5, Q6, Q7, Q8: MMBT4403LT3G; SOT-23
R1, R2, R3, R7, R8, R9, R13, R14: 2kΩ; R_0603_1608Metric
R4, R5, R6, R10, R11, R12, R15, R16: 100kΩ; R_0603_1608Metric
R17, R21, R25, R29, R33, R37, R41, R45: 20kΩ; R_0603_1608Metric
R18, R22, R26, R30, R34, R38, R42, R46: 8.2kΩ; R_0603_1608Metric
R19, R20, R23, R24, R27, R28, R31, R32, R35, R36, R39, R40, R43, R44, R47, R48: 100Ω; R_0603_1608Metric
U1, U2, U3, U4, U5, U6, U7, U8: HX711; SOP-16_3.9x9.9mm_P1.27mm

Connections:
+3.3V: J2.B13, J2.B14, U1.16 (DVDD), U2.16 (DVDD), U3.16 (DVDD), U4.16 (DVDD), U5.16 (DVDD), U6.16 (DVDD), U7.16 (DVDD), U8.16 (DVDD)
+5V: C1.2, C5.2, C9.2, C13.2, C17.2, C21.2, C25.2, C29.2, J2.A13, J2.A14, Q1.2 (E), Q2.2 (E), Q3.2 (E), Q4.2 (E), Q5.2 (E), Q6.2 (E), Q7.2 (E), Q8.2 (E), U1.1 (VSUP), U2.1 (VSUP), U3.1 (VSUP), U4.1 (VSUP), U5.1 (VSUP), U6.1 (VSUP), U7.1 (VSUP), U8.1 (VSUP)
/HX1_A+: J1.3, J3.2, R6.1
/HX1_DT: J2.B4, U1.12 (DOUT)
/HX1_E+: C2.2, J1.1, J3.1, Q1.3 (C), R17.2, U1.3 (AVDD)
/HX2_A+: J1.7, J3.4, R5.1
/HX2_DT: J2.B5, U2.12 (DOUT)
/HX2_E+: C6.2, J1.5, J3.3, Q2.3 (C), R21.2, U2.3 (AVDD)
/HX3_A+: J1.11, J3.6, R4.1
/HX3_DT: J2.B6, U3.12 (DOUT)
/HX3_E+: C10.2, J1.9, J3.5, Q3.3 (C), R25.2, U3.3 (AVDD)
/HX4_A+: J1.15, J3.8, R10.1
/HX4_DT: J2.B7, U4.12 (DOUT)
/HX4_E+: C14.2, J1.13, J3.7, Q4.3 (C), R29.2, U4.3 (AVDD)
/HX5_A+: J4.3, J5.2, R12.1
/HX5_DT: J2.B8, U5.12 (DOUT)
/HX5_E+: C18.2, J4.1, J5.1, Q5.3 (C), R33.2, U5.3 (AVDD)
/HX6_A+: J4.7, J5.4, R11.1
/HX6_DT: J2.A7, U6.12 (DOUT)
/HX6_E+: C22.2, J4.5, J5.3, Q6.3 (C), R37.2, U6.3 (AVDD)
/HX7_A+: J4.11, J5.6, R15.1
/HX7_DT: J2.A8, U7.12 (DOUT)
/HX7_E+: C26.2, J4.9, J5.5, Q7.3 (C), R41.2, U7.3 (AVDD)
/HX8_A+: J4.15, J5.8, R16.1
/HX8_DT: J2.A9, U8.12 (DOUT)
/HX8_E+: C30.2, J4.13, J5.7, Q8.3 (C), R45.2, U8.3 (AVDD)
/HX711 1/A+: R3.2, R6.2, R19.2
/HX711 2/A+: R2.2, R5.2, R23.2
/HX711 3/A+: R1.2, R4.2, R27.2
/HX711 4/A+: R7.2, R10.2, R31.2
/HX711 5/A+: R9.2, R12.2, R35.2
/HX711 6/A+: R8.2, R11.2, R39.2
/HX711 7/A+: R13.2, R15.2, R43.2
/HX711 8/A+: R14.2, R16.2, R47.2
/HX_CLK: J2.A10, U1.11 (PD_SCK), U2.11 (PD_SCK), U3.11 (PD_SCK), U4.11 (PD_SCK), U5.11 (PD_SCK), U6.11 (PD_SCK), U7.11 (PD_SCK), U8.11 (PD_SCK)
GND: C1.1, C2.1, C3.1, C5.1, C6.1, C7.1, C9.1, C10.1, C11.1, C13.1, C14.1, C15.1, C17.1, C18.1, C19.1, C21.1, C22.1, C23.1, C25.1, C26.1, C27.1, C29.1, C30.1, C31.1, J1.2, J1.6, J1.10, J1.14, J2.A3, J2.A6, J2.A12, J2.A15, J2.B3, J2.B12, J2.B15, J3.9, J3.11 (P111), J3.13, J3.15, J4.2, J4.6, J4.10, J4.14, J5.9, J5.11 (P111), J5.13, J5.15, R1.1, R2.1, R3.1, R7.1, R8.1, R9.1, R13.1, R14.1, R18.1, R20.2, R22.1, R24.2, R26.1, R28.2, R30.1, R32.2, R34.1, R36.2, R38.1, R40.2, R42.1, R44.2, R46.1, R48.2, U1.5 (AGND), U1.9 (INB-), U1.10 (INB+), U1.14 (XI), U1.15 (RATE), U2.5 (AGND), U2.9 (INB-), U2.10 (INB+), U2.14 (XI), U2.15 (RATE), U3.5 (AGND), U3.9 (INB-), U3.10 (INB+), U3.14 (XI), U3.15 (RATE), U4.5 (AGND), U4.9 (INB-), U4.10 (INB+), U4.14 (XI), U4.15 (RATE), U5.5 (AGND), U5.9 (INB-), U5.10 (INB+), U5.14 (XI), U5.15 (RATE), U6.5 (AGND), U6.9 (INB-), U6.10 (INB+), U6.14 (XI), U6.15 (RATE), U7.5 (AGND), U7.9 (INB-), U7.10 (INB+), U7.14 (XI), U7.15 (RATE), U8.5 (AGND), U8.9 (INB-), U8.10 (INB+), U8.14 (XI), U8.15 (RATE)
unnamed: Q1.1 (B), U1.2 (BASE)
unnamed: R17.1, R18.2, U1.4 (VFB)
unnamed: C3.2, U1.6 (VBG)
unnamed: C4.1, R20.1, U1.7 (INA-)
unnamed: C4.2, R19.1, U1.8 (INA+)
unnamed: Q2.1 (B), U2.2 (BASE)
unnamed: R21.1, R22.2, U2.4 (VFB)
unnamed: C7.2, U2.6 (VBG)
unnamed: C8.1, R24.1, U2.7 (INA-)
unnamed: C8.2, R23.1, U2.8 (INA+)
unnamed: Q3.1 (B), U3.2 (BASE)
unnamed: R25.1, R26.2, U3.4 (VFB)
unnamed: C11.2, U3.6 (VBG)
unnamed: C12.1, R28.1, U3.7 (INA-)
unnamed: C12.2, R27.1, U3.8 (INA+)
unnamed: Q4.1 (B), U4.2 (BASE)
unnamed: R29.1, R30.2, U4.4 (VFB)
unnamed: C15.2, U4.6 (VBG)
unnamed: C16.1, R32.1, U4.7 (INA-)
unnamed: C16.2, R31.1, U4.8 (INA+)
unnamed: Q5.1 (B), U5.2 (BASE)
unnamed: R33.1, R34.2, U5.4 (VFB)
unnamed: C19.2, U5.6 (VBG)
unnamed: C20.1, R36.1, U5.7 (INA-)
unnamed: C20.2, R35.1, U5.8 (INA+)
unnamed: Q6.1 (B), U6.2 (BASE)
unnamed: R37.1, R38.2, U6.4 (VFB)
unnamed: C23.2, U6.6 (VBG)
unnamed: C24.1, R40.1, U6.7 (INA-)
unnamed: C24.2, R39.1, U6.8 (INA+)
unnamed: Q7.1 (B), U7.2 (BASE)
unnamed: R41.1, R42.2, U7.4 (VFB)
unnamed: C27.2, U7.6 (VBG)
unnamed: C28.1, R44.1, U7.7 (INA-)
unnamed: C28.2, R43.1, U7.8 (INA+)
unnamed: Q8.1 (B), U8.2 (BASE)
unnamed: R45.1, R46.2, U8.4 (VFB)
unnamed: C31.2, U8.6 (VBG)
unnamed: C32.1, R48.1, U8.7 (INA-)
unnamed: C32.2, R47.1, U8.8 (INA+)
