calstar/le2-pcb-hardware/(commit log)

2023-08-22 power board schematic
    [PowerBoard_HF2.kicad_pcb, PowerBoard_HF2.kicad_sch]
2023-08-23 Current progress for HX and TC board.
    [HX-board.kicad_sch, TC-board.kicad_sch]
2023-08-24 mosfet board
    [MOSFET-board.kicad_pcb, MOSFET-board.kicad_sch]
2023-08-28 Updated HX, TC boards.
    [HX-board.kicad_sch, TC-board.kicad_sch]
2023-08-29 core board
    [Core-Board.kicad_pcb, Core-Board.kicad_sch]
2023-08-29 core board schematic
    [Core-Board.kicad_sch]
2023-08-30 board updates
    [PowerBoard_HF2.kicad_sch]
2023-08-30 more smol updates
    [Core-Board.kicad_sch, PowerBoard_HF2.kicad_sch]
2023-08-30 Updated schematics of TC,PT
    [HX-board.kicad_sch, TC-board.kicad_sch]
2023-09-01 Updated mosfet schematics
    [MOSFET-board.kicad_pcb, MOSFET-board.kicad_sch]
2023-09-03 Replaced mosfet board with Conor's design using BTS3080EJXUMA1. Modified max31855 symbol to have A (separate assembly) reference designator.
    [MOSFET-board.kicad_sch, TC-board.kicad_sch]
2023-09-05 Updated HX, TC, and MOSFET board.
    [HX-board.kicad_pcb, HX-board.kicad_sch, MOSFET-board.kicad_sch, TC-board.kicad_pcb, TC-board.kicad_sch]
2023-09-05 core board pinouts
    [Core-Board.kicad_sch]
2023-09-06 Updated pcie and fixed HX, MOSFET, TC board. Also added hierarchical sheet.
    [HX-board.kicad_pcb, HX-board.kicad_sch, HX711_breakout.kicad_sch, MOSFET-board.kicad_pcb, MOSFET-board.kicad_sch, TC-board.kicad_pcb, TC-board.kicad_sch, pyro.kicad_sch]
2023-09-08 Basic routing for MOSFET board. Need silkscreen update.
    [MOSFET-board.kicad_pcb, MOSFET-board.kicad_sch, pyro.kicad_sch]
2023-09-09 updates for layout MOSFET/HX
    [HX-board.kicad_pcb, MOSFET-board.kicad_pcb]
2023-09-10 Finished mosfet layout
    [MOSFET-board.kicad_pcb, MOSFET-board.kicad_sch, pyro.kicad_sch]
2023-09-11 Finished Updating the HX Board
    [HX-board.kicad_pcb]
2023-09-11 TC Board (mostly done) and HX Board Done (Mostly)
    [TC-board.kicad_pcb]
2023-09-11 Fixed TC
    [TC-board.kicad_pcb]
2023-09-11 Revert "HX and TC Board mostly finished"
    [HX-board.kicad_pcb, TC-board.kicad_pcb]
2023-09-11 Revert "Revert "HX and TC Board mostly finished""
    This reverts commit 2ae13608b6027366e1c59111a8dca91d16e06deb.
    [HX-board.kicad_pcb, TC-board.kicad_pcb]
2023-09-12 TC Board Done
    [TC-board.kicad_pcb]
2023-09-12 HX and TC Done
    [HX-board.kicad_pcb]
2023-09-12 HX Board
    Forgot to put GND screen on back
    [HX-board.kicad_pcb]
2023-09-12 Finalize core board schematics.
    [Core-Board.kicad_pcb, Core-Board.kicad_sch]
2023-09-12 wired pcie together in core board.
    [Core-Board.kicad_pcb, Core-Board.kicad_sch]
2023-09-13 Finish tracing core board. Need to do cleanup and silkscreen.
    [Core-Board.kicad_pcb, Core-Board.kicad_sch]
2023-09-13 Finished core board.
    [Core-Board.kicad_pcb]
2023-09-14 Fixed labels for TC Board
    [TC-board.kicad_pcb]
2023-09-14 final vers
    [Core-Board.kicad_pcb]
2023-09-15 Generated PCB Manufactures
    [HX-board-B_Cu.gbr, HX-board-B_Mask.gbr, HX-board-B_Paste.gbr, HX-board-B_Silkscreen.gbr, HX-board-Edge_Cuts.gbr, HX-board-F_Cu.gbr, HX-board-F_Mask.gbr, HX-board-F_Paste.gbr]
2023-09-15 Organized files for Gerber
    [HX-board-B_Cu.gbr, HX-board-B_Mask.gbr, HX-board-B_Paste.gbr, HX-board-B_Silkscreen.gbr, HX-board-Edge_Cuts.gbr, HX-board-F_Cu.gbr, HX-board-F_Mask.gbr, HX-board-F_Paste.gbr]
2023-09-28 Updated TC gerber
    [TC-board-B_Cu.gbr, TC-board-B_Mask.gbr, TC-board-B_Paste.gbr, TC-board-B_Silkscreen.gbr, TC-board-Edge_Cuts.gbr, TC-board-F_Cu.gbr, TC-board-F_Mask.gbr, TC-board-F_Paste.gbr]
2023-09-28 tc drill files
    [TC-board-B_Cu.gbr, TC-board-B_Mask.gbr, TC-board-B_Paste.gbr, TC-board-B_Silkscreen.gbr, TC-board-Edge_Cuts.gbr, TC-board-F_Cu.gbr, TC-board-F_Mask.gbr, TC-board-F_Paste.gbr]
2023-10-22 MOSFET Board Updated
    MOSFET Board changes, new PCB Design and updated schematic.
    [MOSFET-board.kicad_pcb]
2023-10-22 MOSFET Board Updated (Part II)
    Added double header GPIO and should be fine now :P
    [MOSFET-board.kicad_pcb]
2023-10-22 Updated MOSFET (part III)
    Made sure there were 0 errors.
    [MOSFET-board.kicad_pcb]
2023-10-23 MOSFET Board Updated (Part IV? I lost count)
    Has a specified op amp, fixed measurements, should be a double header GPIO, I believe that everything is connected. The only warnings are either silk screen or non labeled items, which should be fine.
    [MOSFET-board.kicad_pcb, pyro.kicad_sch]
2023-10-23 Gerber files + Drill Files
    I think that's all?
    [MOSFET-board-B_Cu.gbr, MOSFET-board-B_Mask.gbr, MOSFET-board-B_Paste.gbr, MOSFET-board-B_Silkscreen.gbr, MOSFET-board-Edge_Cuts.gbr, MOSFET-board-F_Cu.gbr, MOSFET-board-F_Mask.gbr, MOSFET-board-F_Paste.gbr]
2023-10-23 Extra Files for MOSFET order
    I think these are right?
    [MOSFET-board.csv, MOSFET-board.kicad_pcb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]
2024-01-03 Progress on revising ground boards.
    [BOM-MOSFET-board.csv, Core-Board.csv, Core-Board.kicad_sch, HX-board.csv, HX-board.kicad_sch, HX711_breakout.kicad_sch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]
2024-01-04 Further revision. Two batteries system.
    [Core-Board.kicad_sch, MOSFET-board.kicad_sch, TC-board.kicad_sch, max31855_breakout.kicad_sch, pyro.kicad_sch]
2024-01-04 Added level shifter for gpio expander.
    [MOSFET-board.kicad_sch, i2c_level_shifter.kicad_sch]
2024-01-04 Added an spi expander to core board.
    [Core-Board.kicad_sch]
2024-01-07 Revising PCIe.
    [Core-Board.kicad_sch, HX-board.kicad_sch, MOSFET-board.kicad_sch, TC-board.kicad_sch]
2024-01-08 Ironing out small details, changed pcf8575 to IC instead of breakout.
    [Core-Board.kicad_sch, HX-board.kicad_sch, HX711_breakout.kicad_sch, MOSFET-board.kicad_sch, TC-board.kicad_sch, i2c_level_shifter.kicad_sch, max31855_breakout.kicad_sch, pyro.kicad_sch]
2024-01-27 Separated into ground/flight/com system
    [BOM-MOSFET-board.csv, Core-Board.csv, Core-Board.kicad_pcb, Core-Board.kicad_sch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]
2024-01-27 removed old files
    [BOM-MOSFET-board.csv, Core-Board.csv, Core-Board.kicad_pcb, Core-Board.kicad_sch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]
2024-01-27 COM Board
    hi.
    [COM-Board.kicad_pcb, COM-Board.kicad_sch]
2024-01-30 Skeleton for flight module.
    [COM-Board.kicad_pcb, COM-Board.kicad_sch, Connector-board.kicad_pcb, Connector-board.kicad_sch, Core-board.kicad_pcb, Core-board.kicad_sch, Flight_board.DXF, HX711_breakout.kicad_sch]
2024-01-30 Added a gpio expander to power board.
    [Power-board.kicad_sch, pyro.kicad_sch]
2024-01-31 skeleton for connector board
    [Connector-board.kicad_sch, Core-board.kicad_sch]
2024-02-09 power board updated
    [Power-board.kicad_sch, i2c_level_shifter.kicad_sch, pyro.kicad_sch]
2024-02-09 worked on core-board schematic. Not done.
    [Connector-board.kicad_sch, Core-board.kicad_pcb, Core-board.kicad_sch, ESP32-Breakout.kicad_sch, HX711_breakout.kicad_sch, max31855_breakout.kicad_sch]
2024-02-11 updated power board.
    [Power-board.kicad_sch]
2024-02-11 Updated core-board
    [Core-board.kicad_sch, ESP32-Breakout.kicad_sch, HX711_breakout.kicad_sch, Power-board.kicad_sch]
2024-02-13 update on flight pcbs
    [Connector-board.kicad_sch, Core-board.kicad_sch, ESP32-Breakout.kicad_sch, Power-board.kicad_sch, i2c_level_shifter.kicad_sch, pyro.kicad_sch]
2024-02-13 added diodes to 'OR' REDS-vent with on-board mosfets.
    [Connector-board.kicad_sch]
2024-02-14 Updated power mux circuit.
    [Connector-board.kicad_sch, Power-board.kicad_sch]
2024-02-19 Commit changes to the Connector
    [Connector-board.kicad_sch, max31855_breakout.kicad_sch]
2024-02-21 Progress on core board.
    [Core-Board.csv, Core-Board.kicad_pcb, Core-Board.kicad_sch, Core-board.kicad_pcb, Core-board.kicad_sch, ESP32-Breakout.kicad_sch, HX711_breakout.kicad_sch]
2024-02-21 board comments
    [Connector-board.kicad_sch, Core-board.kicad_sch, ESP32-Breakout.kicad_sch, Power-board.kicad_sch]
2024-02-22 Edited the connector board to make sense
    [Connector-board.kicad_pcb, Connector-board.kicad_sch]
2024-02-22 changed the flags, checked for ERC <3
    [Connector-board.kicad_sch]
2024-02-22 commit edits to the schematic to reflect new pinouts
    [Connector-board.kicad_pcb, Connector-board.kicad_sch]
2024-02-23 Finished flight-core.
    [Core-board.kicad_pcb, Core-board.kicad_sch, ESP32-Breakout.kicad_sch, HX711_breakout.kicad_sch]
2024-02-24 completed routing
    [Connector-board.kicad_pcb]
2024-02-25 Commit - corrections from Dulanya
    [Connector-board.kicad_pcb, Connector-board.kicad_sch]
2024-02-25 Updated core board.
    [Core-board.kicad_pcb, ESP32-Breakout.kicad_sch]
2024-02-25 Commit edits part 2
    [Connector-board.kicad_pcb]
2024-02-25 Merged power board
    [Power-board.csv, Power-board.kicad_pcb, Power-board.kicad_sch, i2c_level_shifter.kicad_sch, pyro.kicad_sch]
2024-02-25 added star logo onto power board
    [Power-board.kicad_pcb]
2024-02-25 commit - pretty much final unless any major concerns are discovered.
    [Connector-board.csv, Connector-board.kicad_pcb]
2024-02-25 fixed some power board issues
    [Power-board.kicad_pcb]
2024-02-25 removed 3.3v planes
    [Connector-board - Connector-board.csv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]
2024-02-26 final boards orderedd
    [Connector-board-B_Cu.gbr, Connector-board-B_Mask.gbr, Connector-board-B_Paste.gbr, Connector-board-B_Silkscreen.gbr, Connector-board-Edge_Cuts.gbr, Connector-board-F_Cu.gbr, Connector-board-F_Mask.gbr, Connector-board-F_Paste.gbr]
2024-03-23 Minor changes to footprint library
    [Core-board.kicad_pcb, Core-board.kicad_sch, ESP32-Breakout.kicad_sch]
2024-03-25 change the USB layout
    [Core-board.kicad_pcb, ESP32-Breakout.kicad_sch]
2024-03-26 finished the connector board
    [Connector-board.kicad_pcb]
2024-03-26 connector fix - change to SMD
    [Connector-board.kicad_pcb, Connector-board.kicad_sch]
2024-03-26 added silkscreen cover
    [Core-board.kicad_pcb]
2024-03-26 connector board updates for manufacturing
    [Connector-board - Connector-board.csv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]
2024-03-26 connector gerbs
    [Connector-board-B_Cu.gbr, Connector-board-B_Mask.gbr, Connector-board-B_Paste.gbr, Connector-board-B_Silkscreen.gbr, Connector-board-Edge_Cuts.gbr, Connector-board-F_Cu.gbr, Connector-board-F_Mask.gbr, Connector-board-F_Paste.gbr]
2024-03-26 in the middle of updating micro usb
    [Core-board.kicad_pcb, ESP32-Breakout.kicad_sch]
2024-03-26 still updating micro usb
    [ESP32-Breakout.kicad_sch]
2024-03-26 ON GOD ITS DONE
    [Core-board.kicad_pcb, ESP32-Breakout.kicad_sch]
2024-03-26 manufacturing files or core
    [Core-board-B_Cu.gbr, Core-board-B_Mask.gbr, Core-board-B_Paste.gbr, Core-board-B_Silkscreen.gbr, Core-board-Edge_Cuts.gbr, Core-board-F_Cu.gbr, Core-board-F_Mask.gbr, Core-board-F_Paste.gbr]
2024-03-29 components list
    [Connector-board.csv, Core-board.csv]
2024-05-01 zipping files no changes lol
    [SD-Breakout-B_Cu.gbr, SD-Breakout-B_Mask.gbr, SD-Breakout-B_Paste.gbr, SD-Breakout-B_Silkscreen.gbr, SD-Breakout-Edge_Cuts.gbr, SD-Breakout-F_Cu.gbr, SD-Breakout-F_Mask.gbr, SD-Breakout-F_Paste.gbr]
2024-05-02 core board sd card and HX2 HX6 changes
    [Core-board-B_Cu.gbr, Core-board-B_Mask.gbr, Core-board-B_Paste.gbr, Core-board-B_Silkscreen.gbr, Core-board-Edge_Cuts.gbr, Core-board-F_Cu.gbr, Core-board-F_Mask.gbr, Core-board-F_Paste.gbr]
